andredxc/Microcontroladores/esquematico/final.pdf

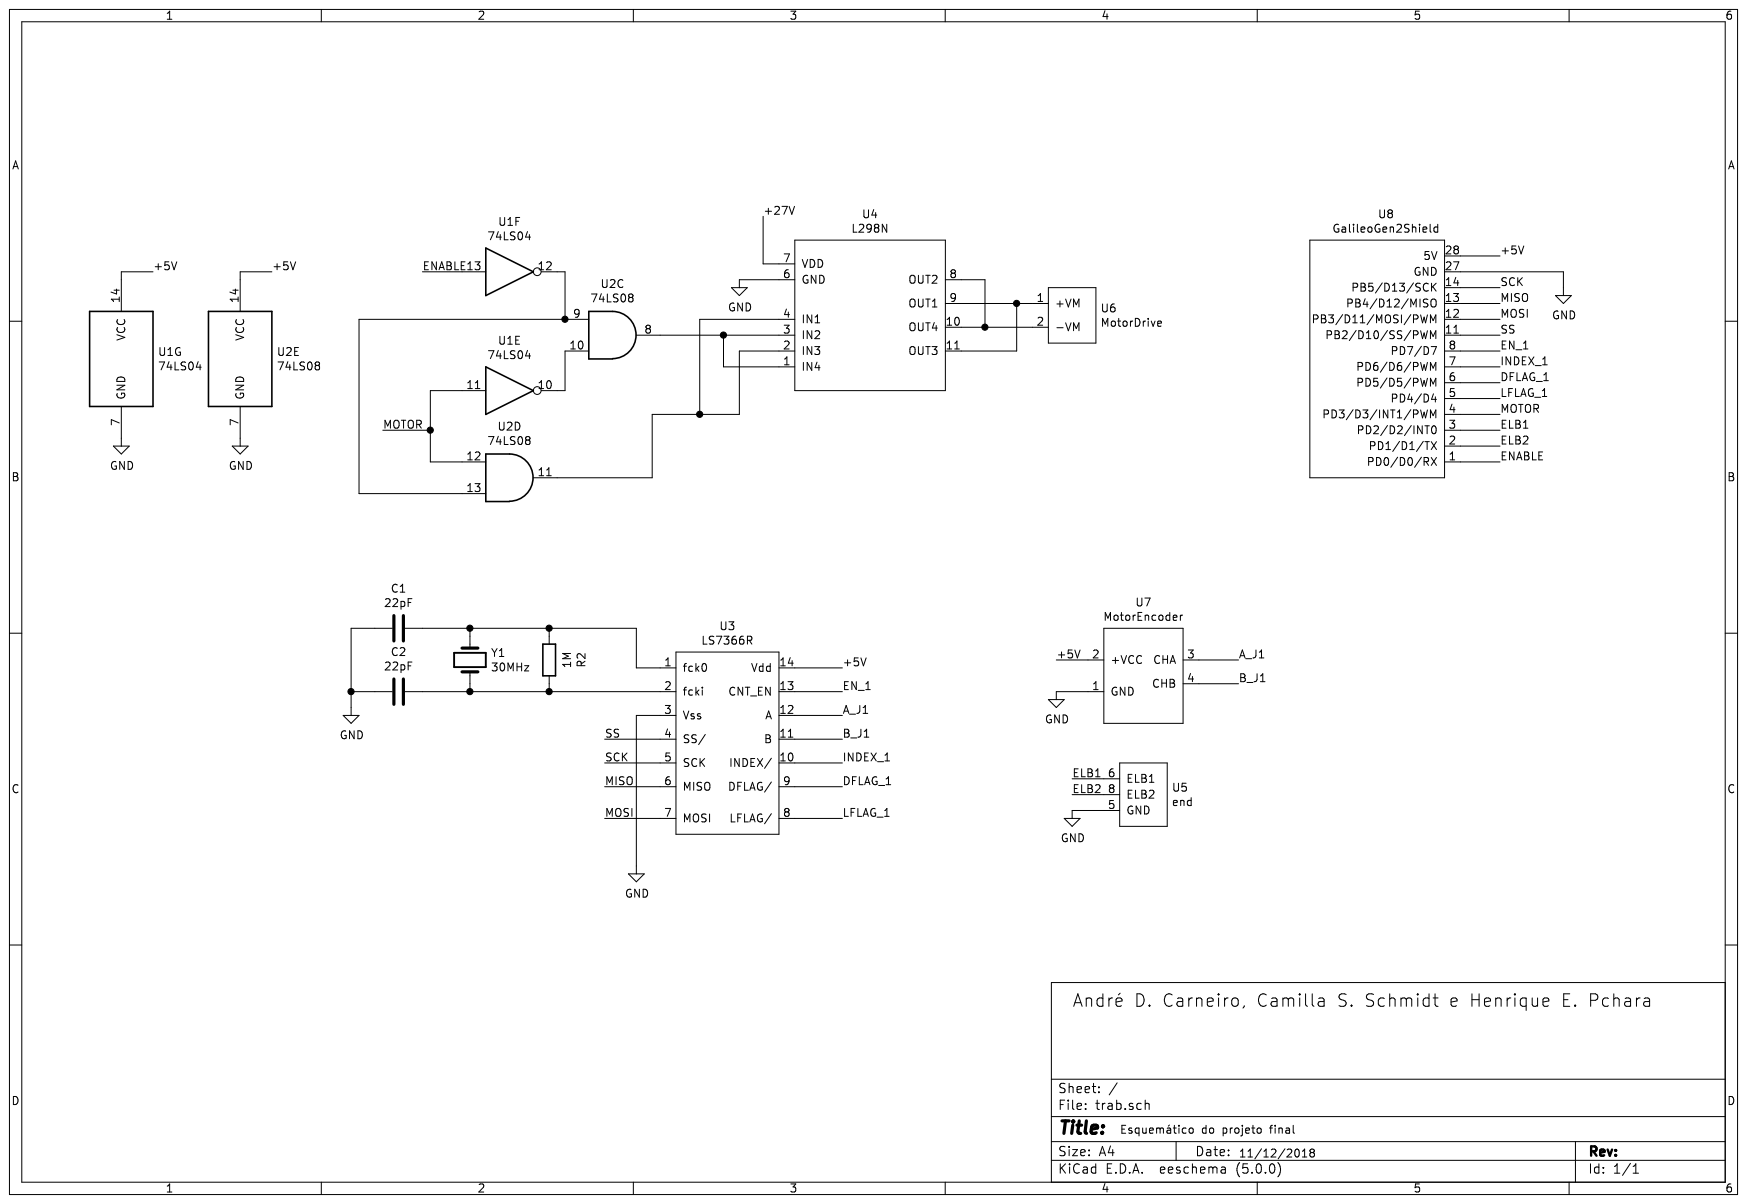
[picture p5: page 1]
