andredxc/Microcontroladores/PCB/versao3.pdf

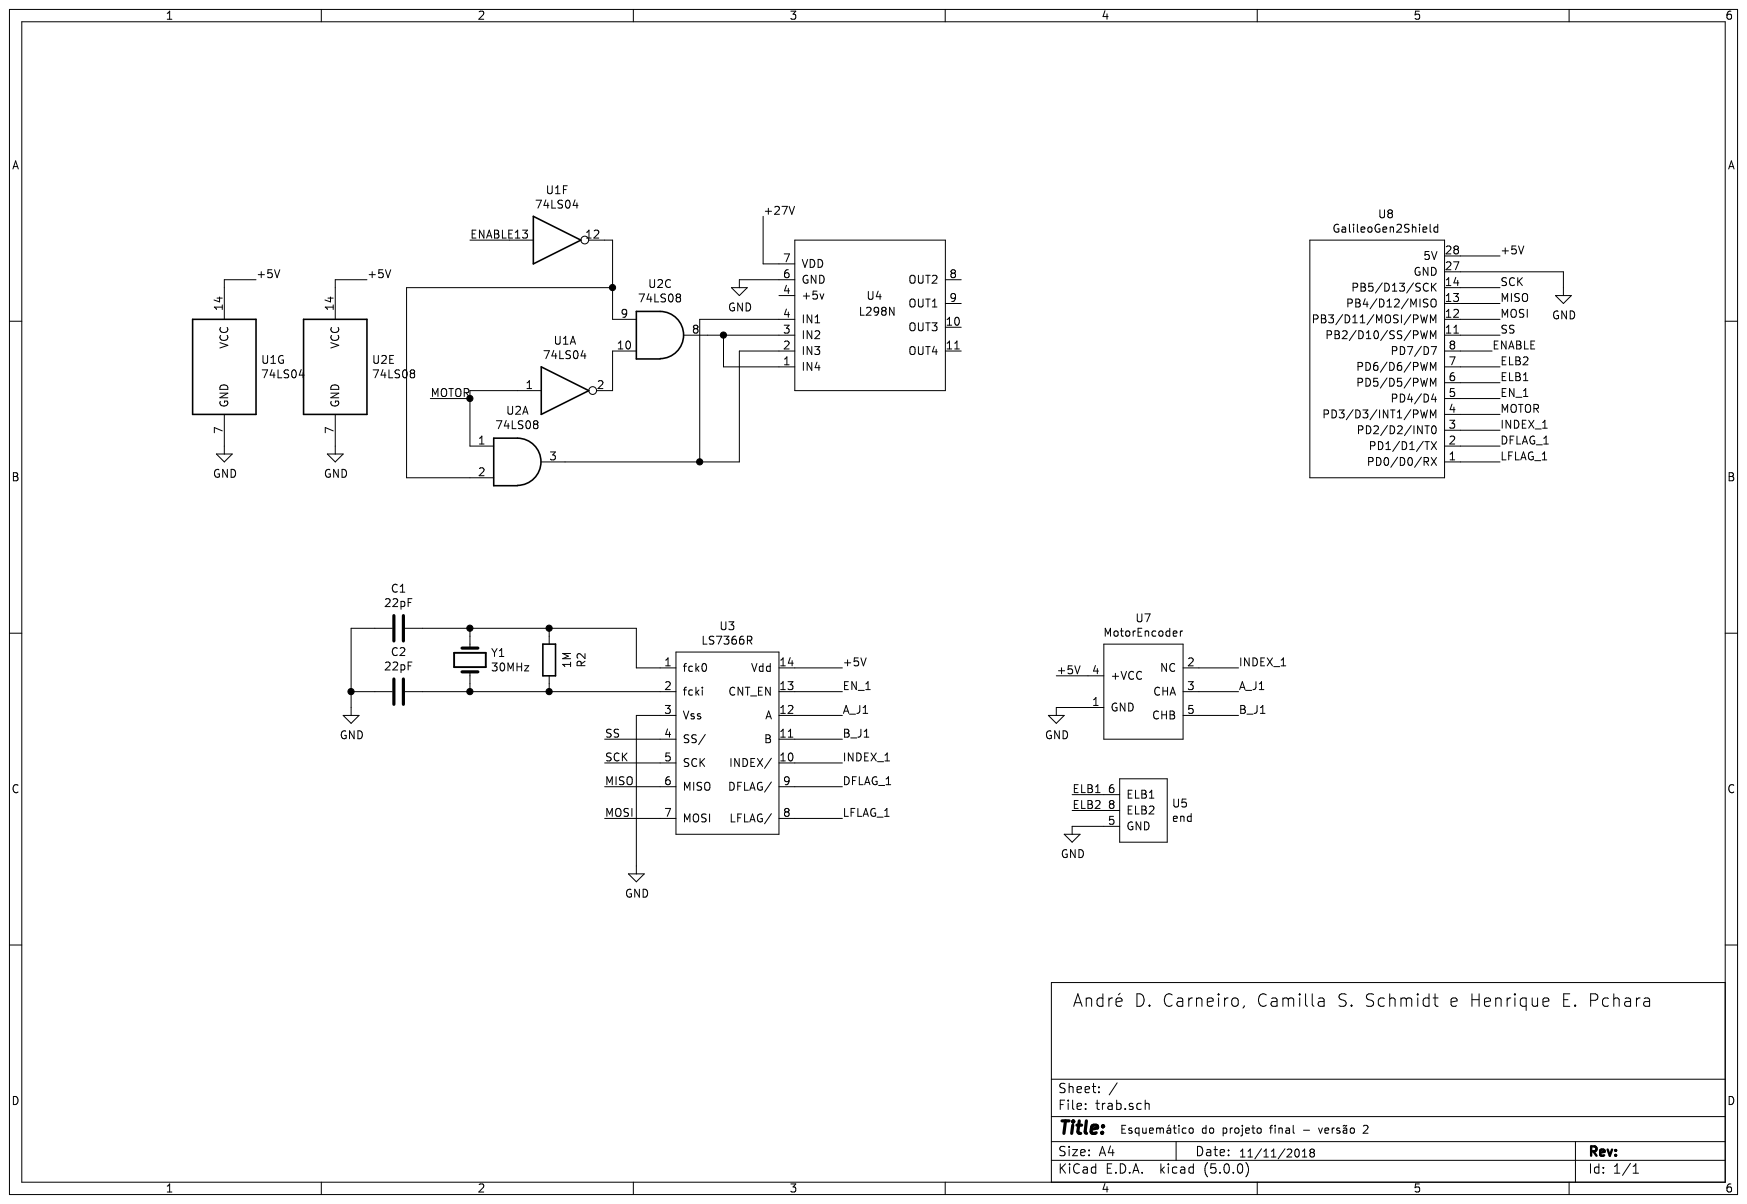
[picture p6: page 1]
