andredxc/Microcontroladores/PCB/versao2.pdf

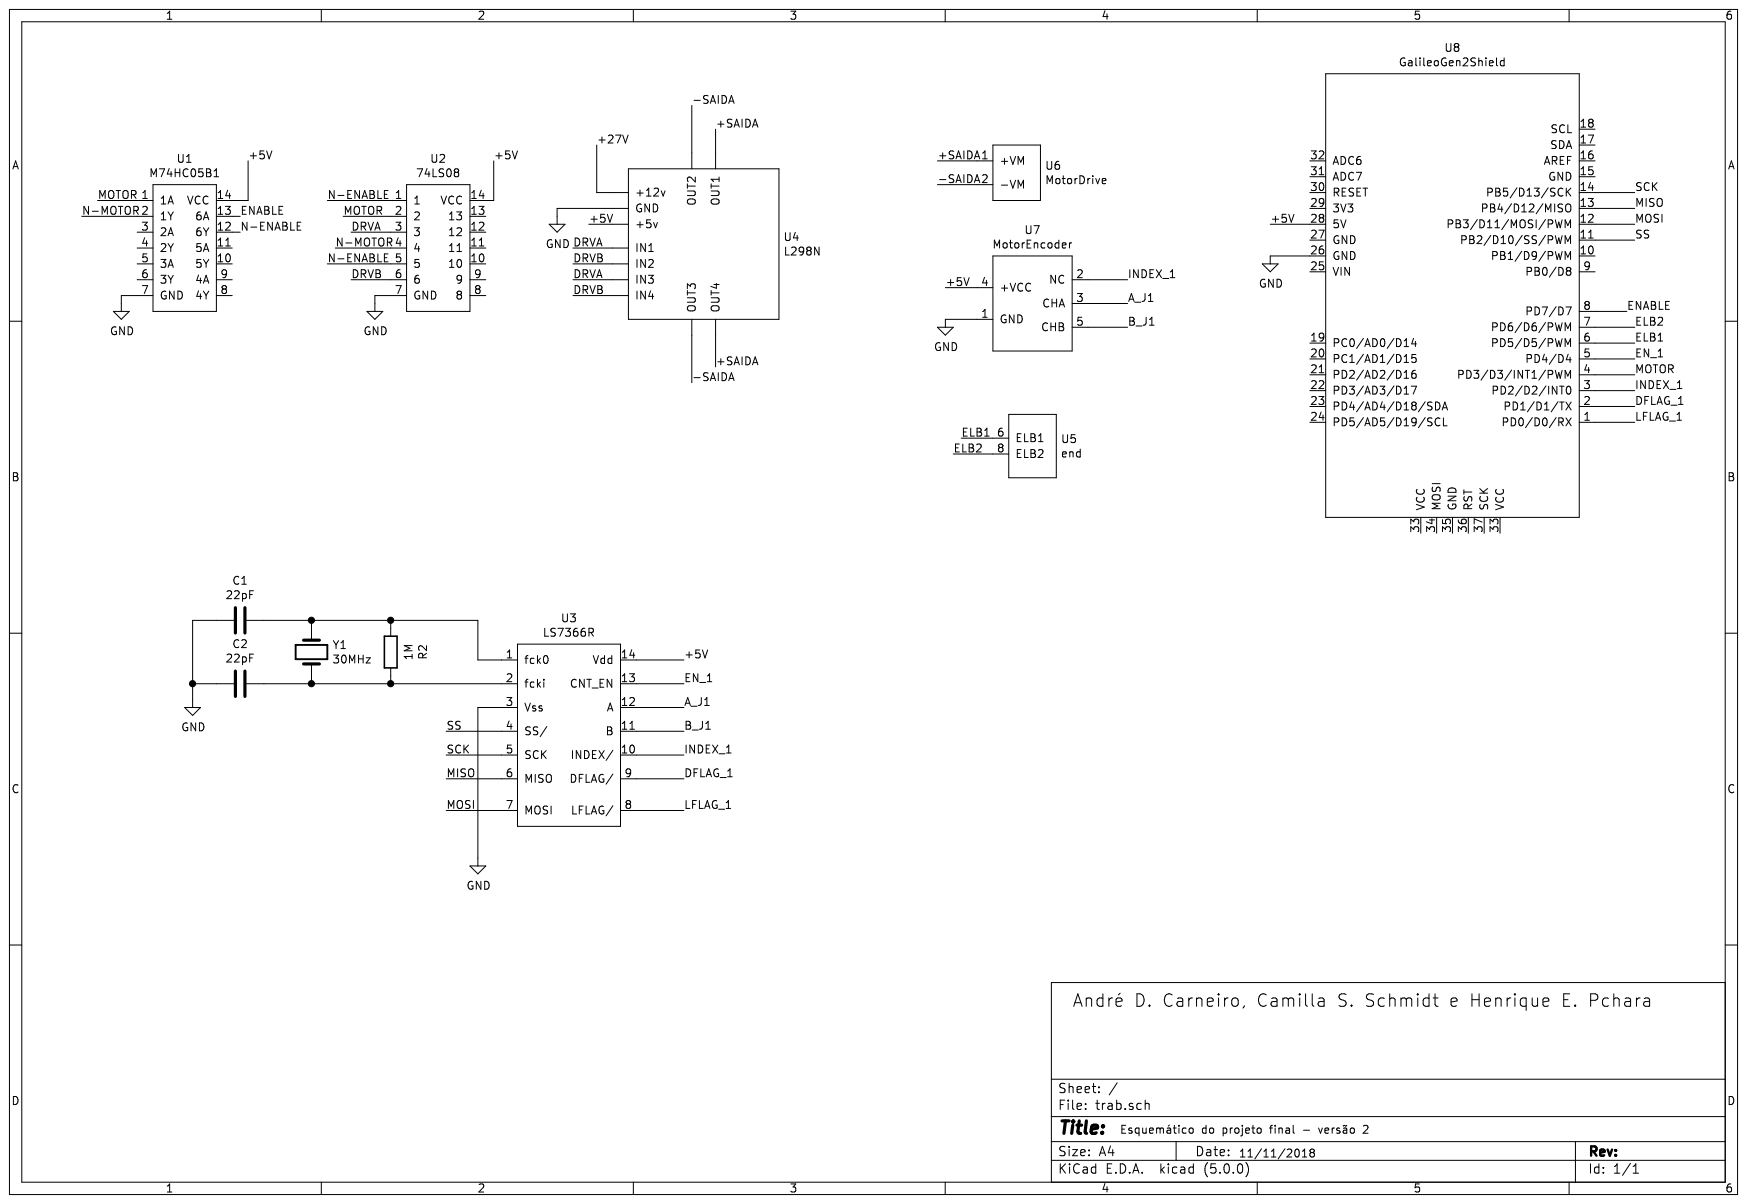
[picture p7: page 1]
