andredxc/Microcontroladores/Entrega/Esquemáticos/layout_all_layers.pdf

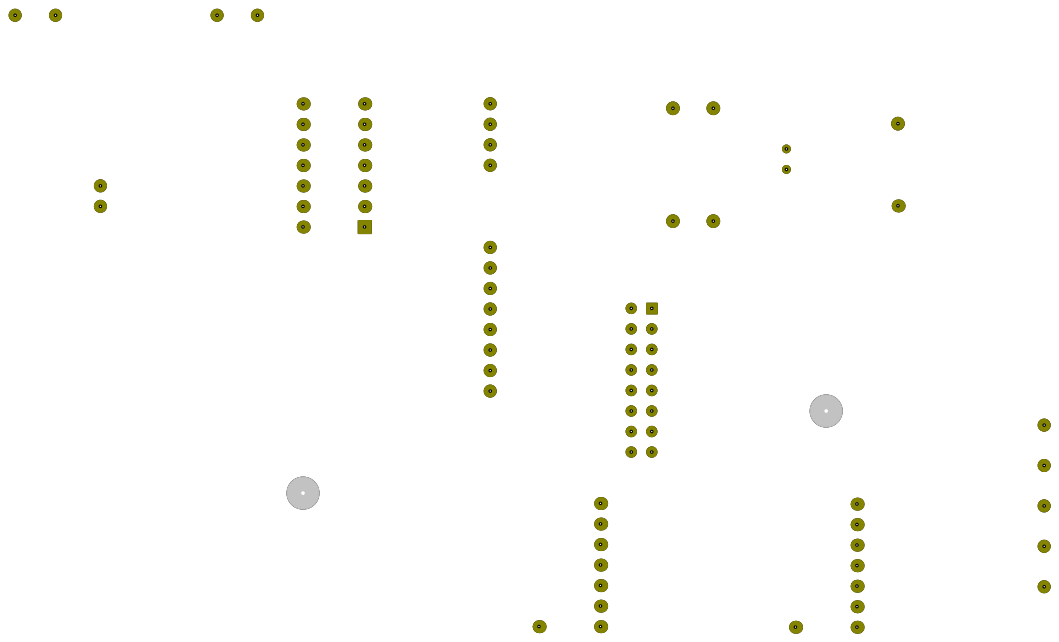
[picture p8: page 1]

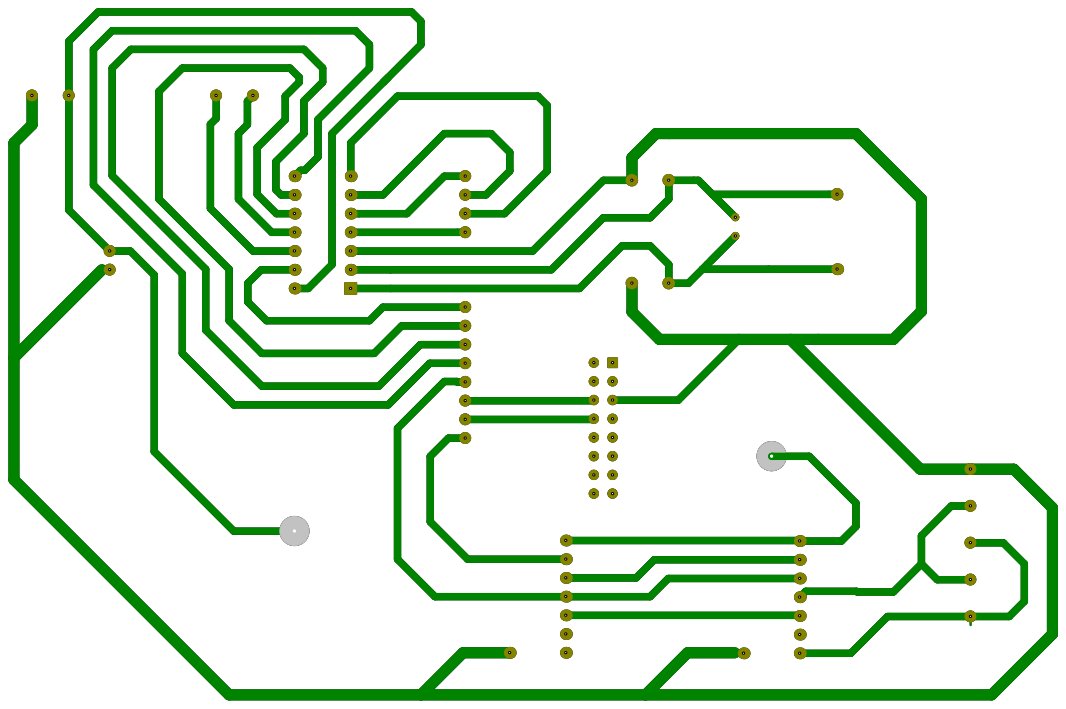
[picture p9: page 2]

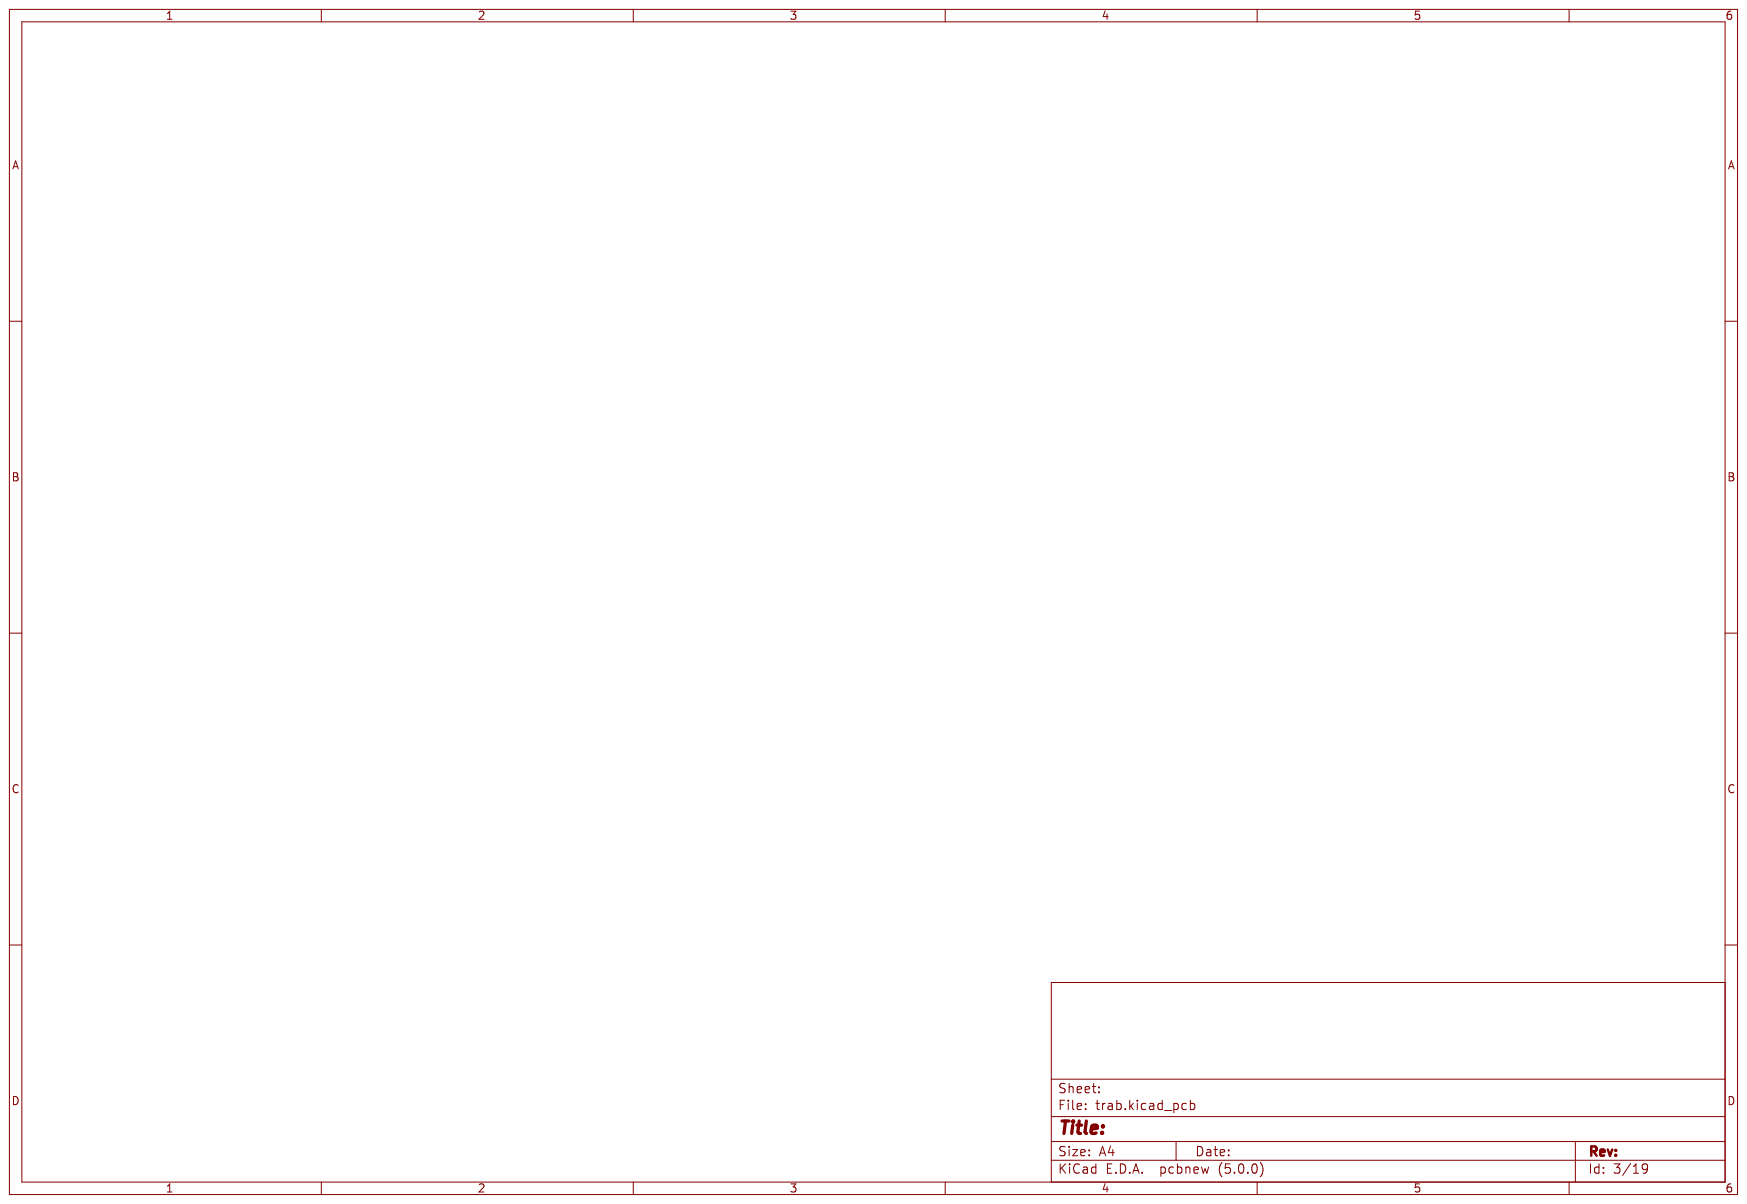
[picture p10: page 3]

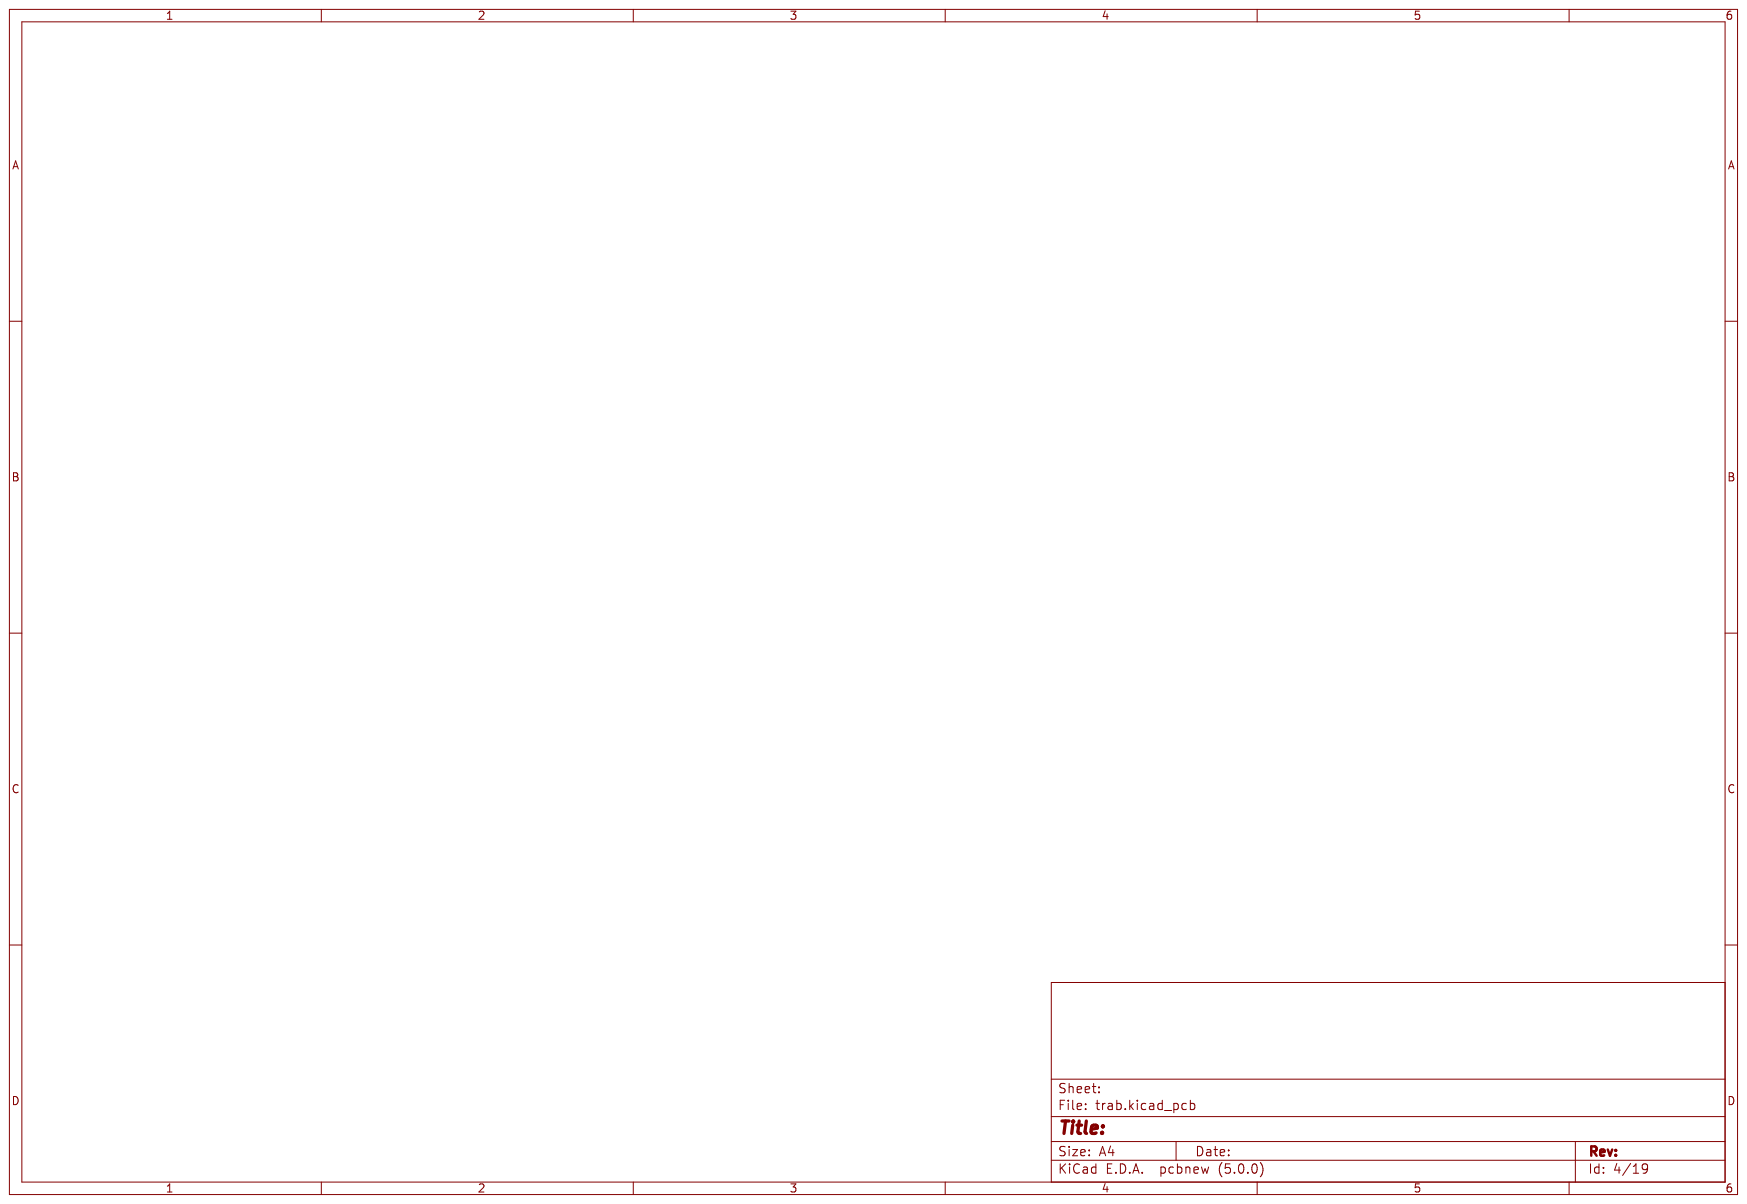
[picture p11: page 4]

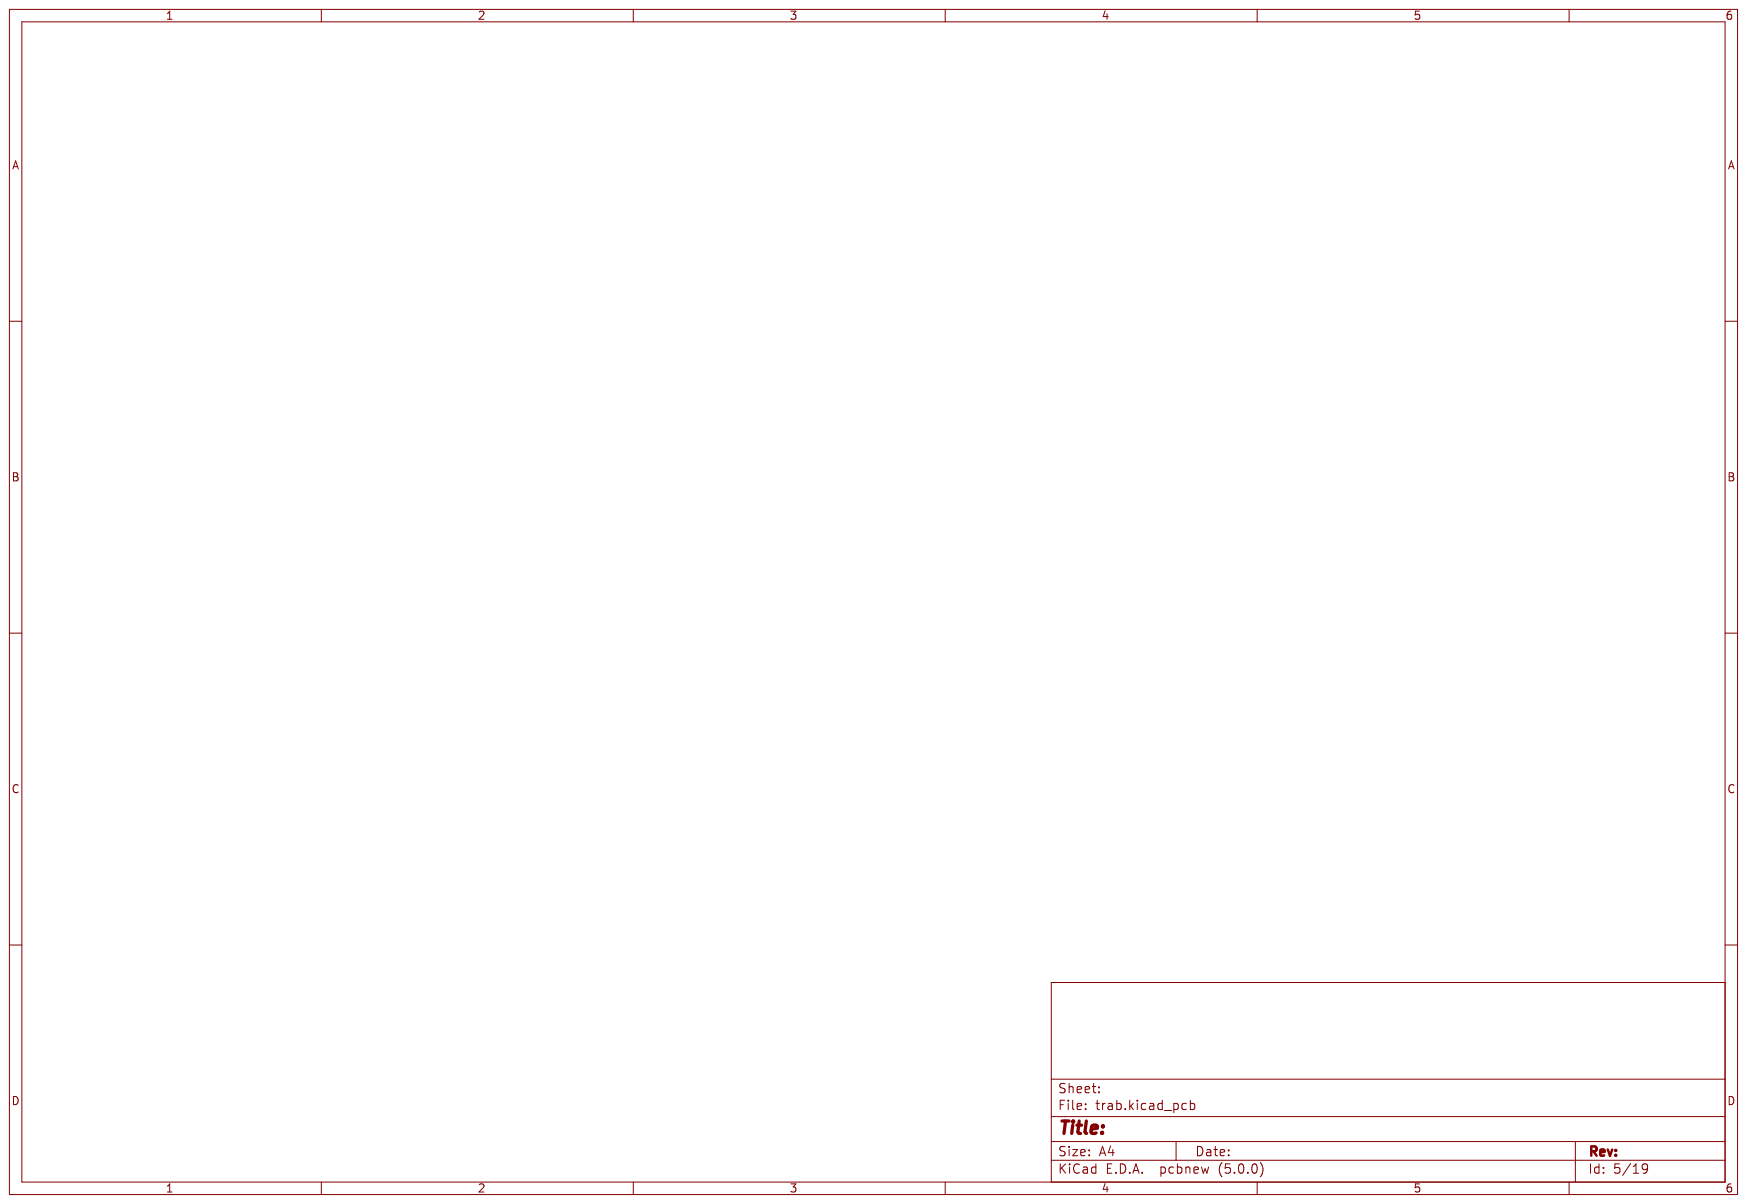
[picture p12: page 5]

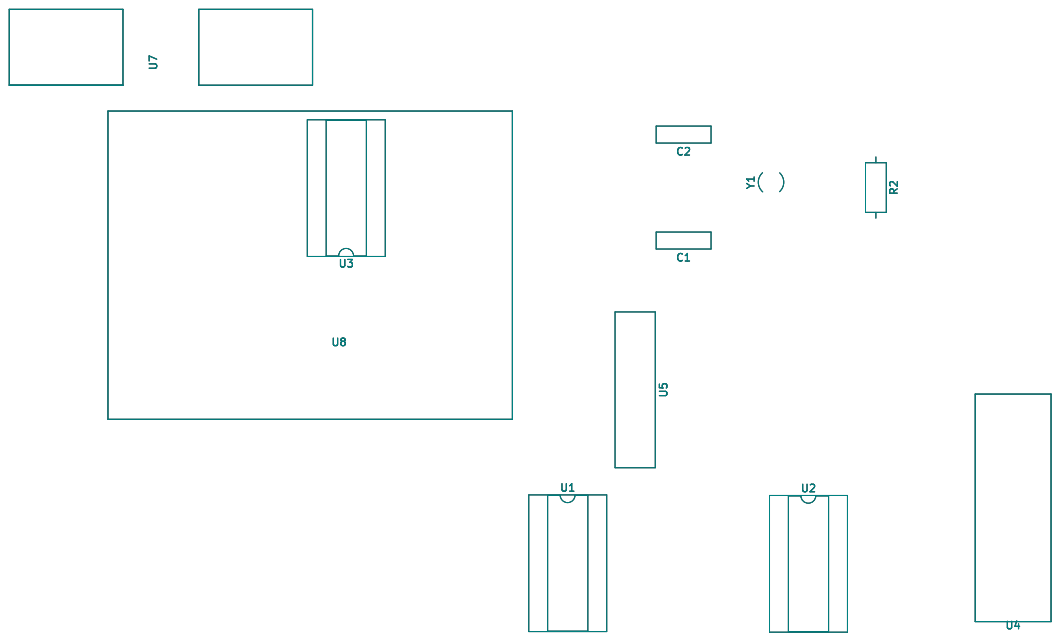
[picture p13: page 6]

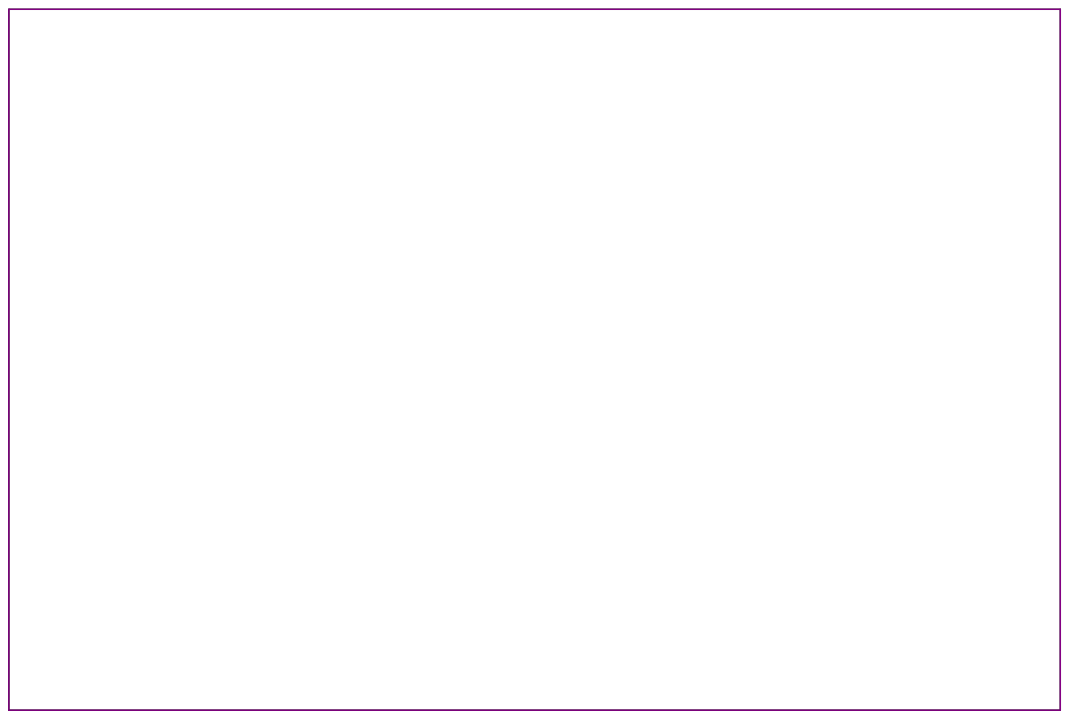
[picture p14: page 7]

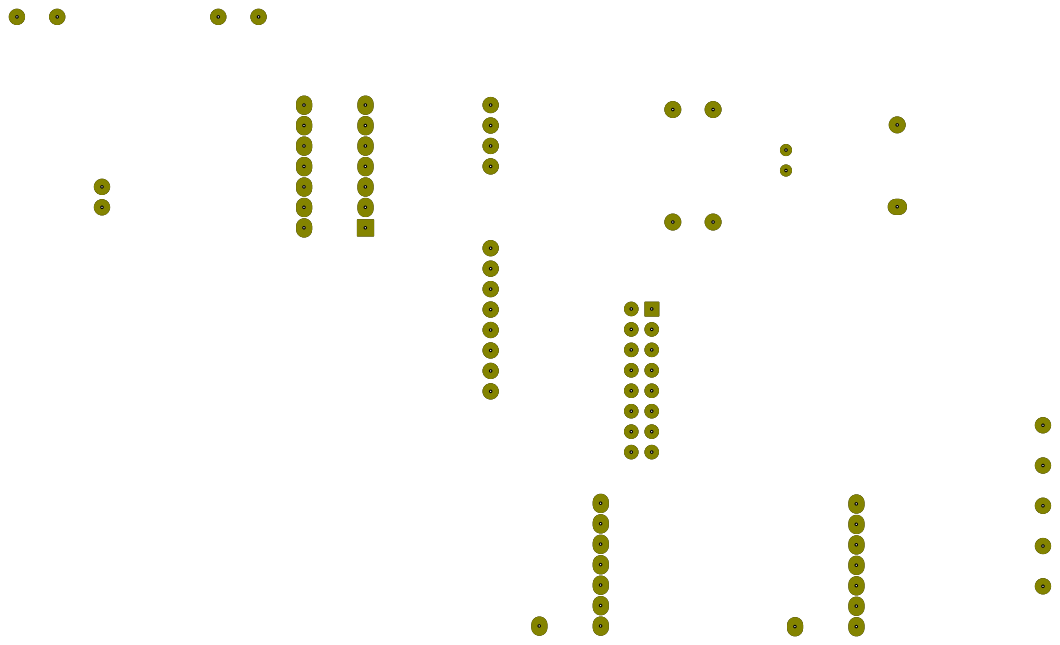
[picture p15: page 8]

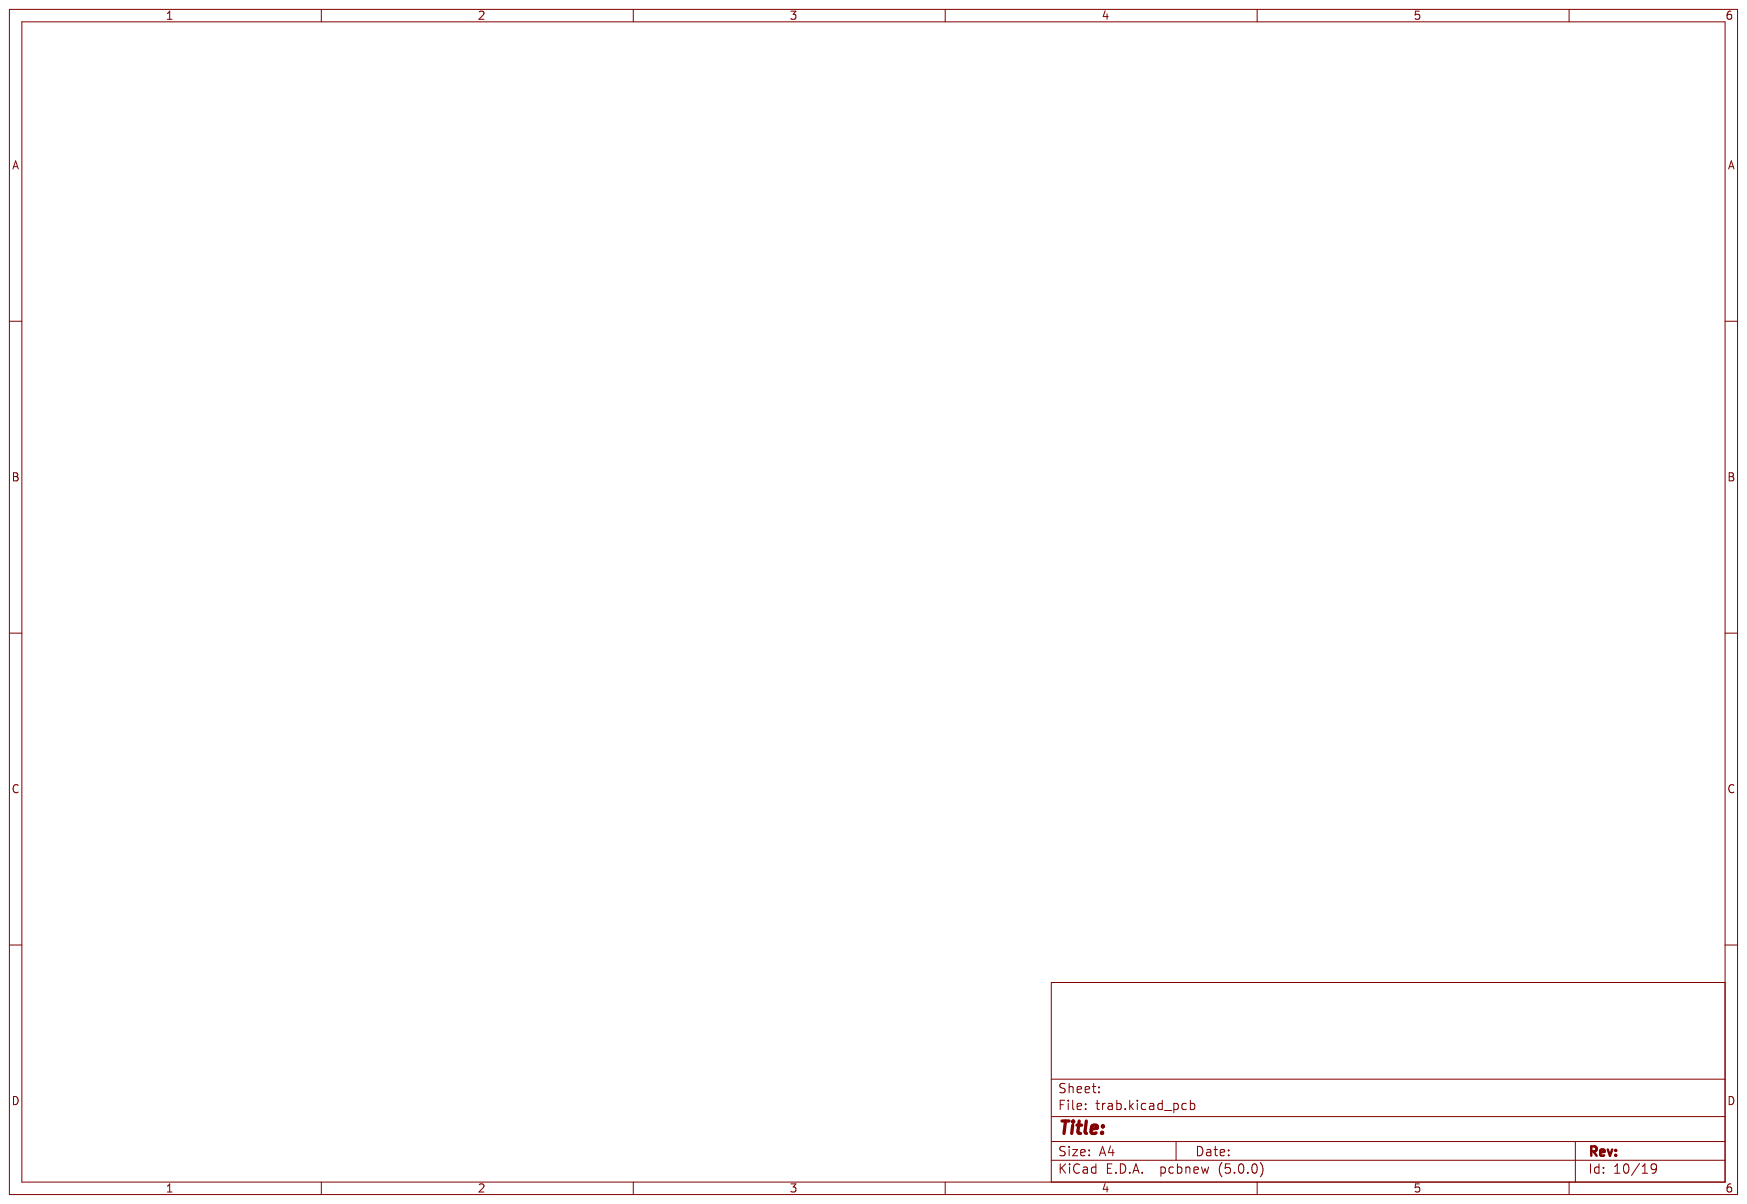
[picture p16: page 10]

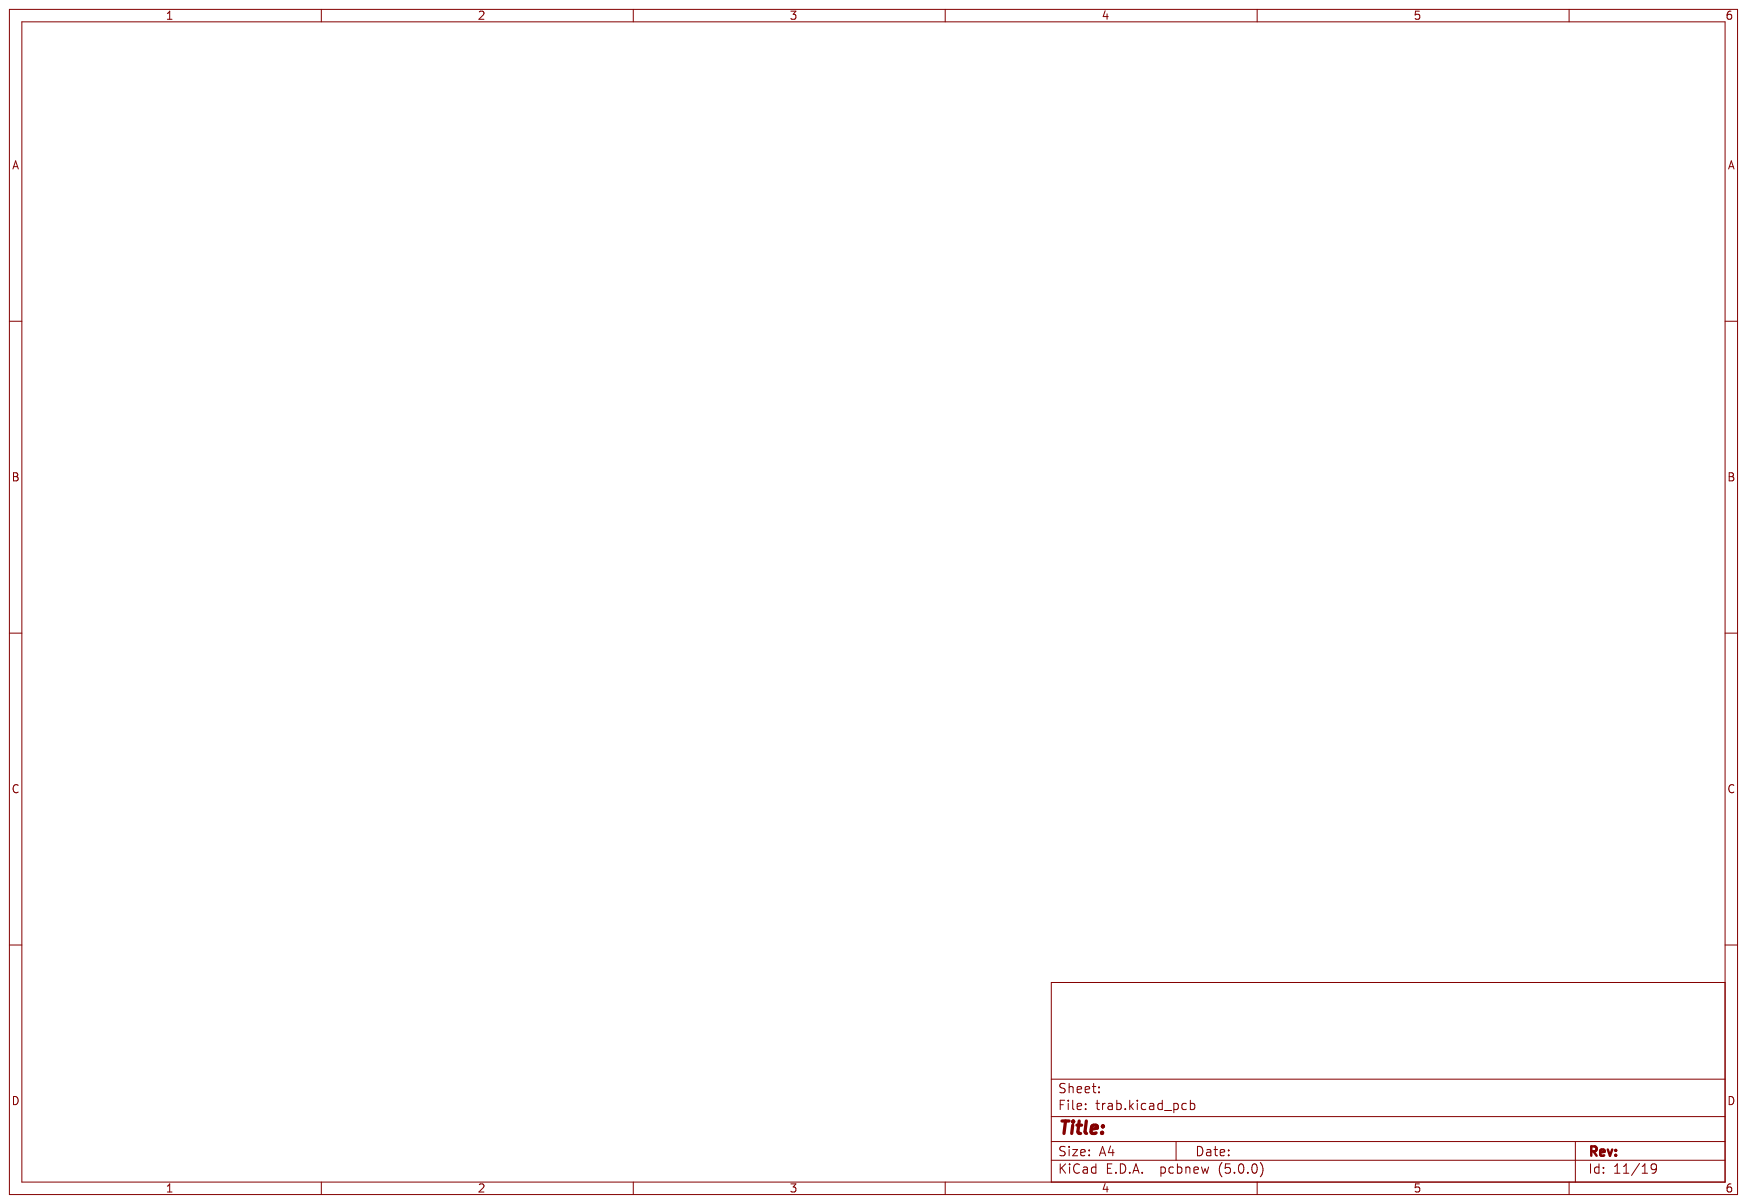
[picture p17: page 11]

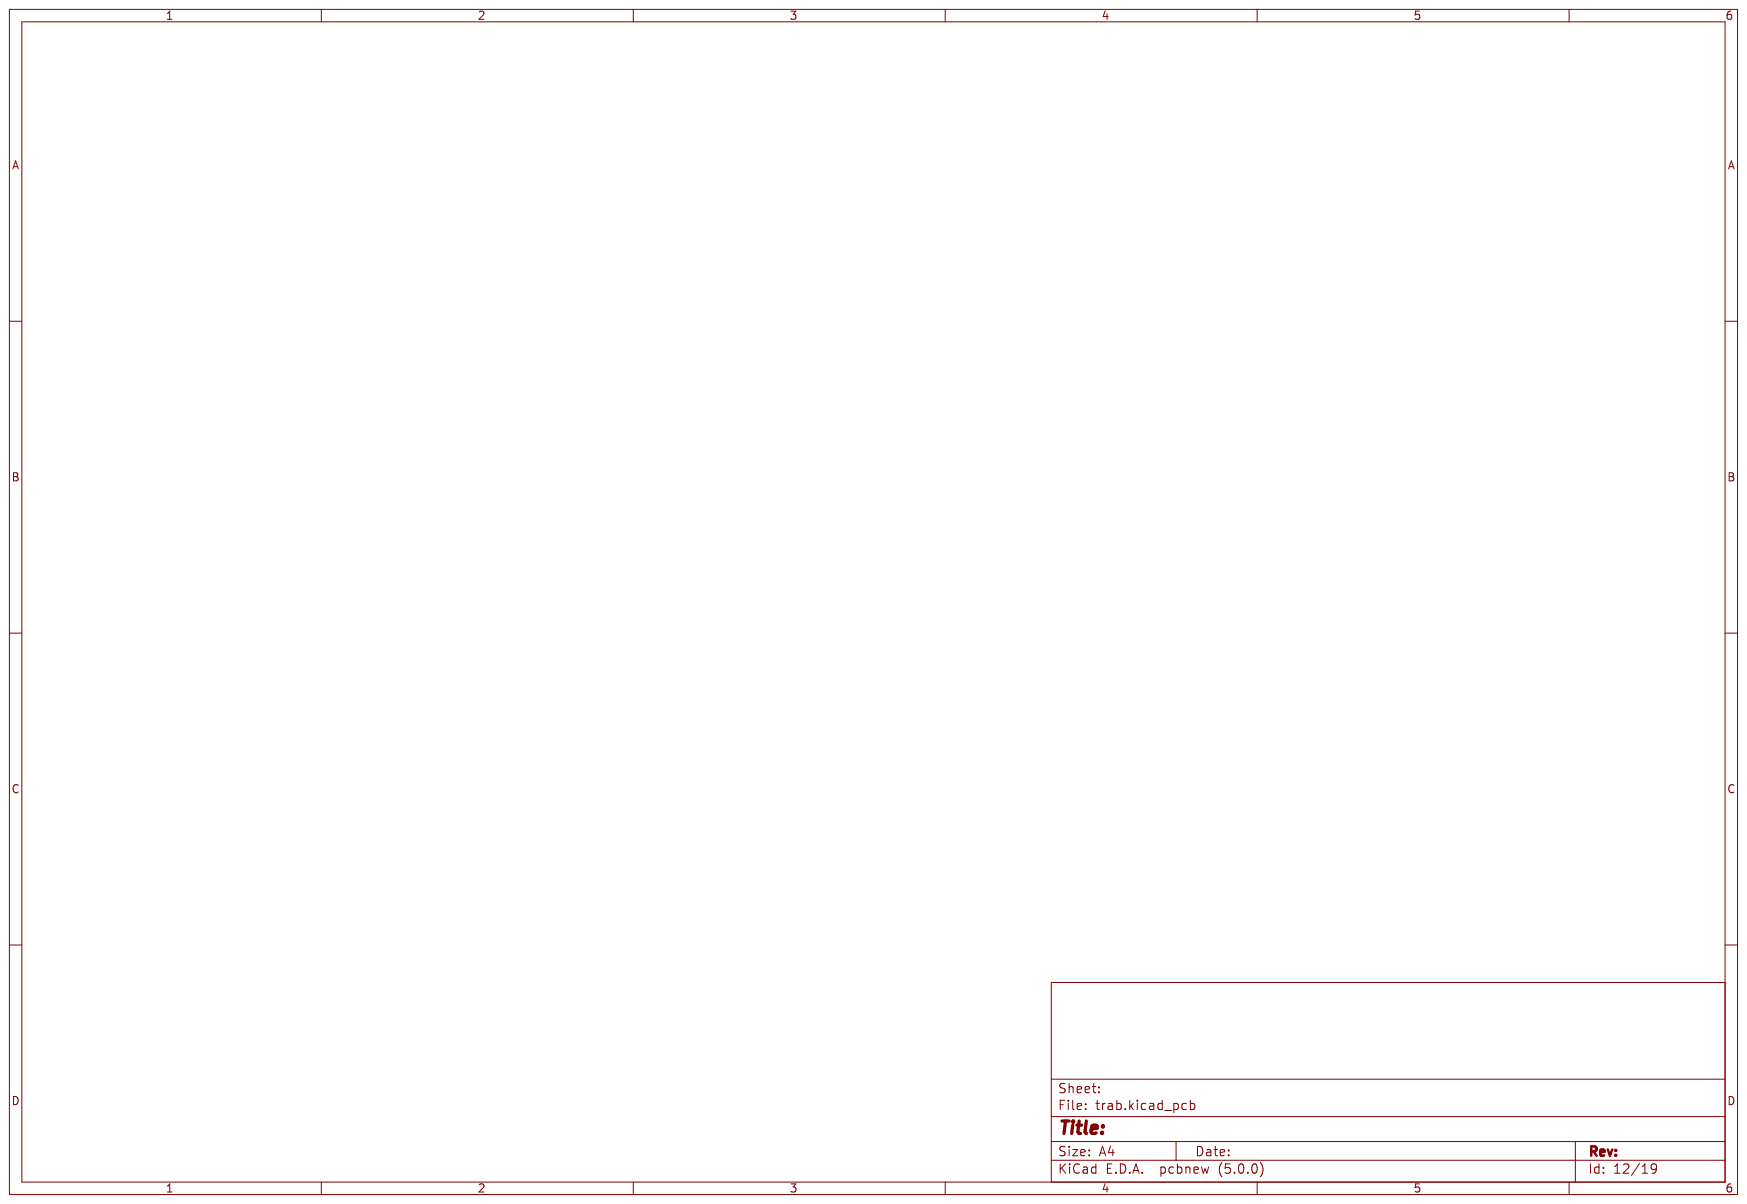
[picture p18: page 12]

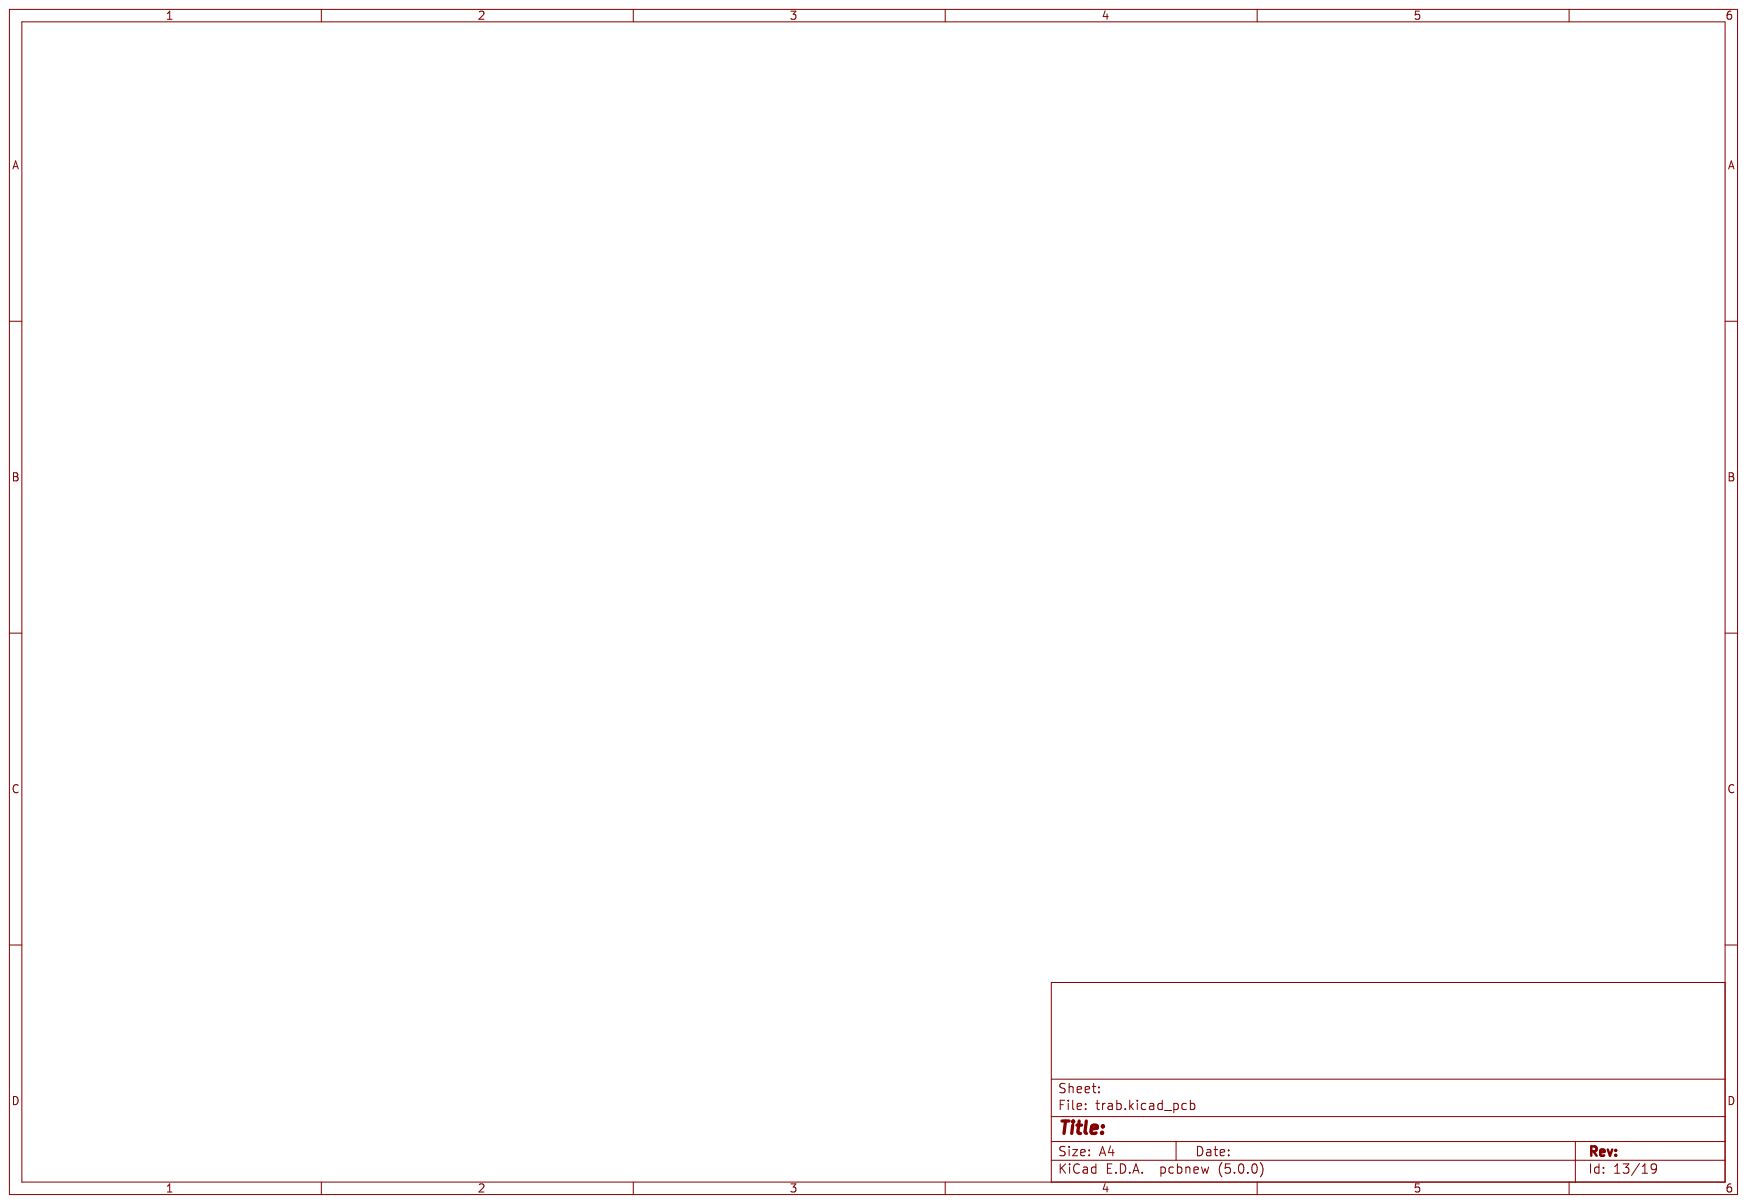
[picture p19: page 13]

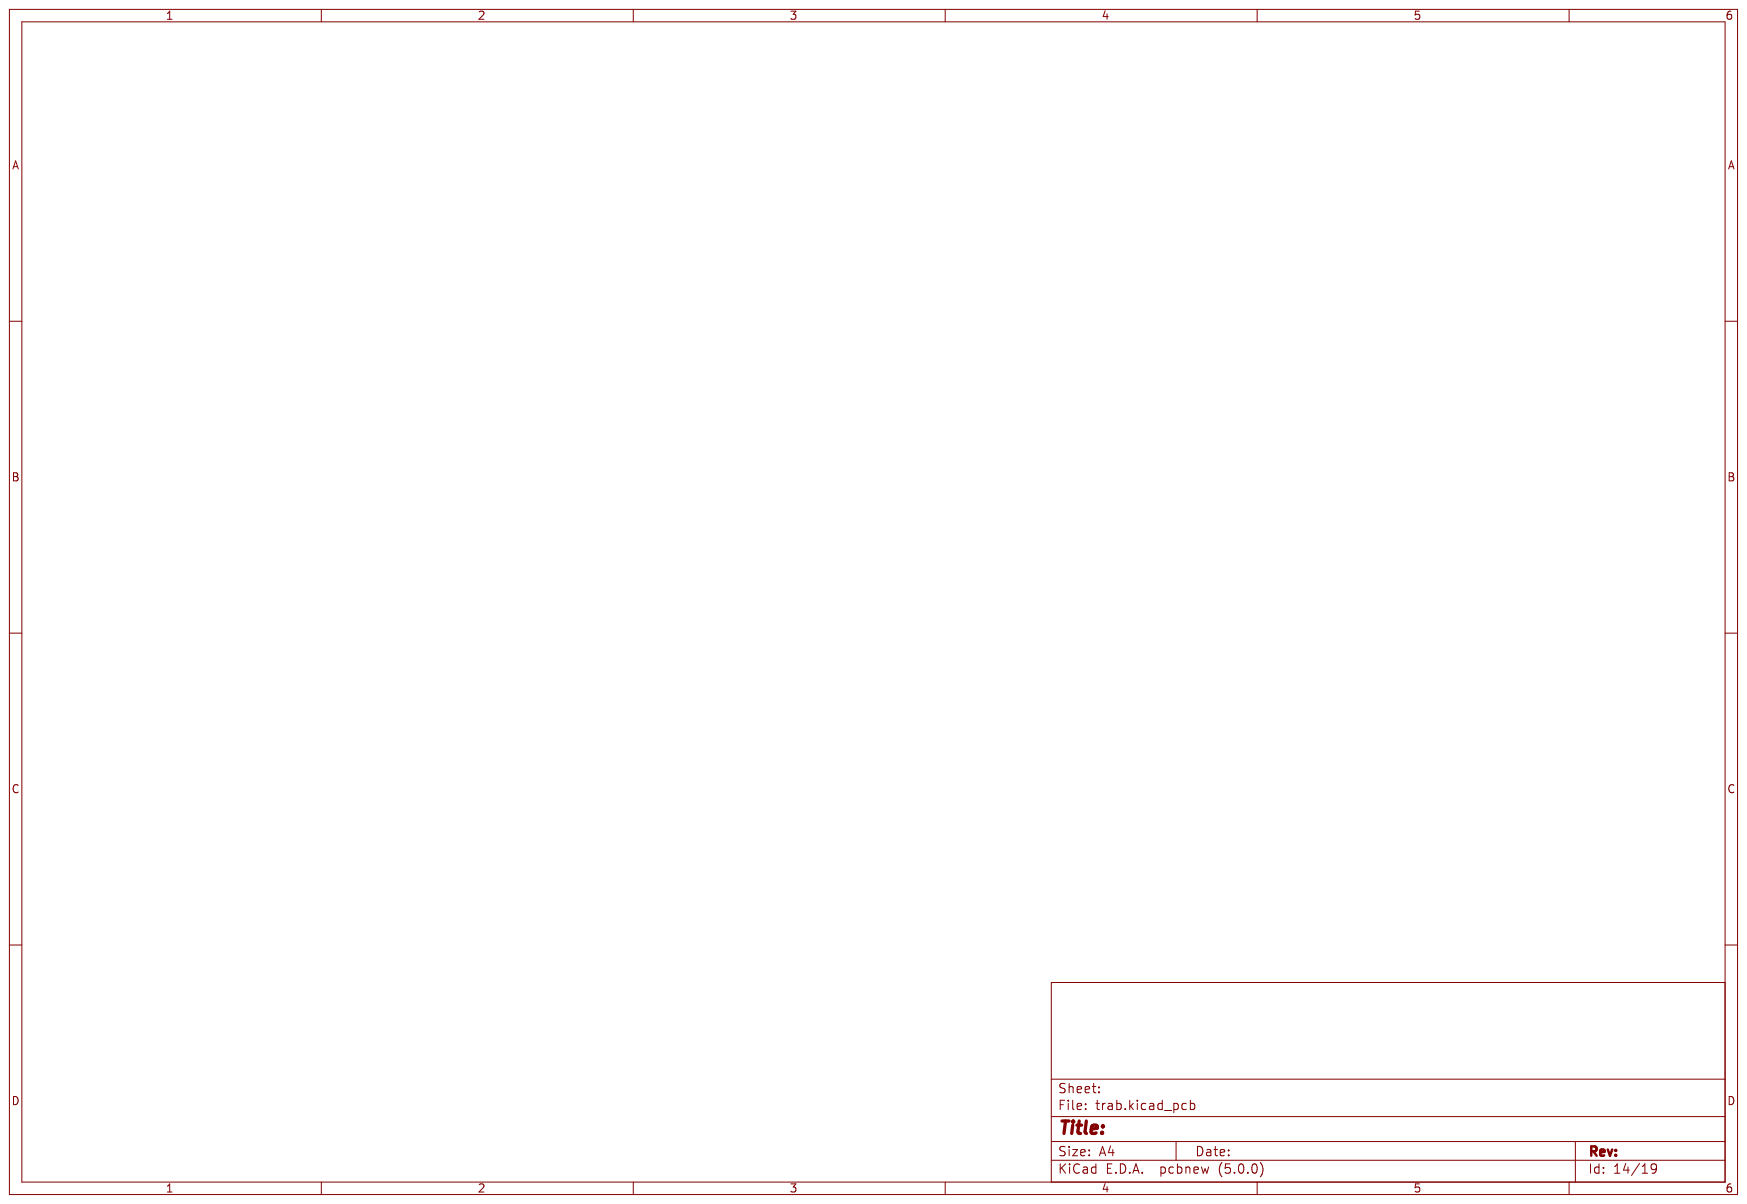
[picture p20: page 14]

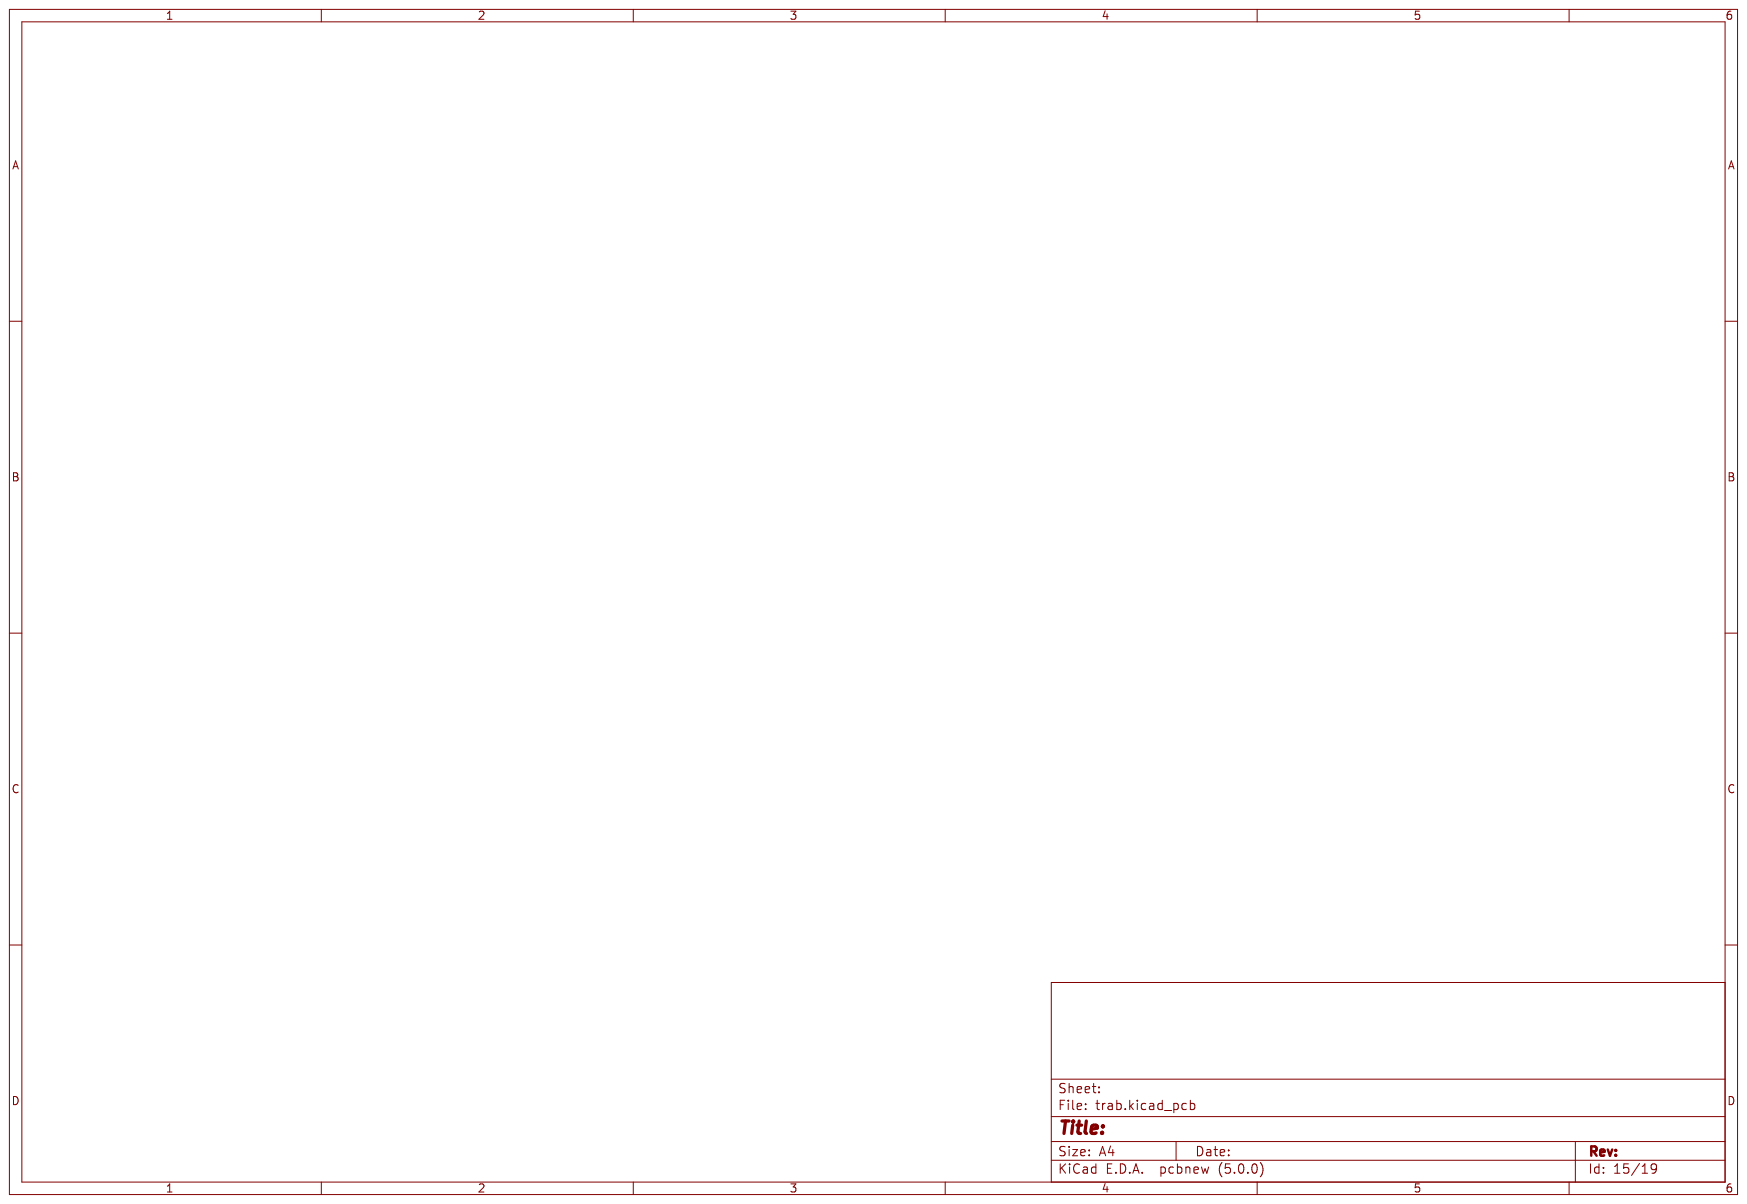
[picture p21: page 15]

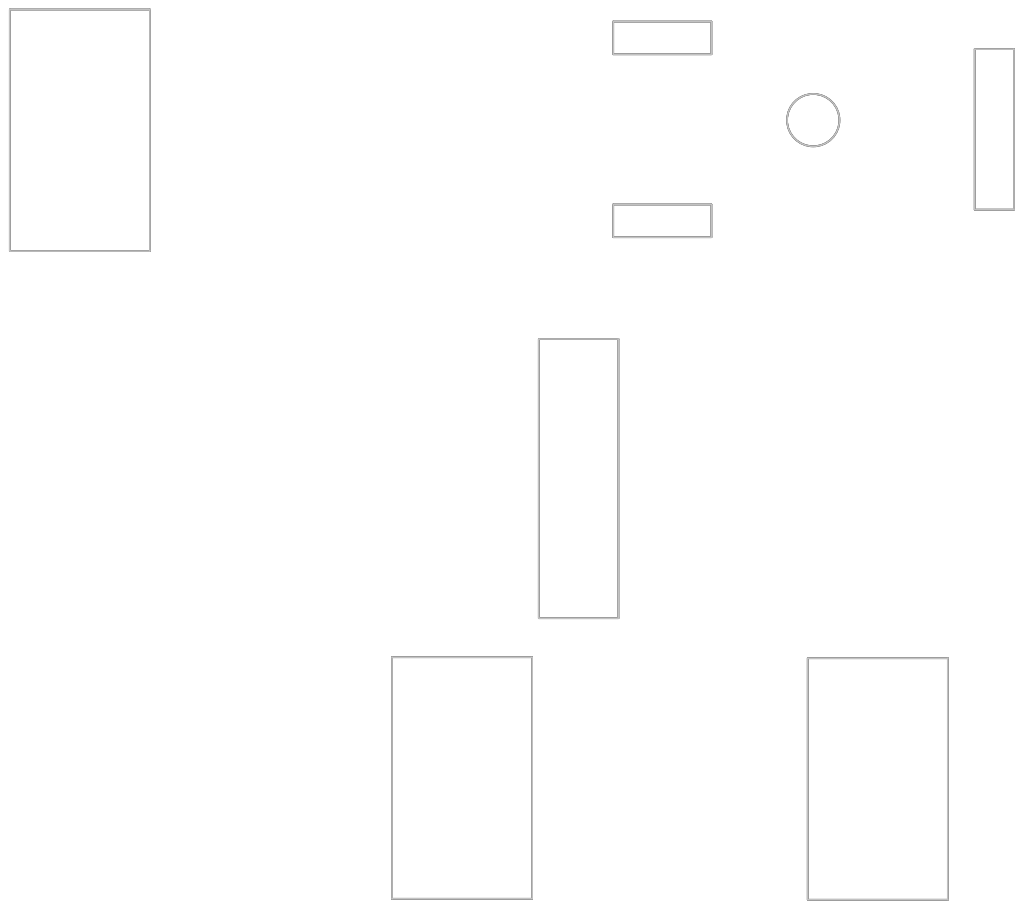
[picture p22: page 16]

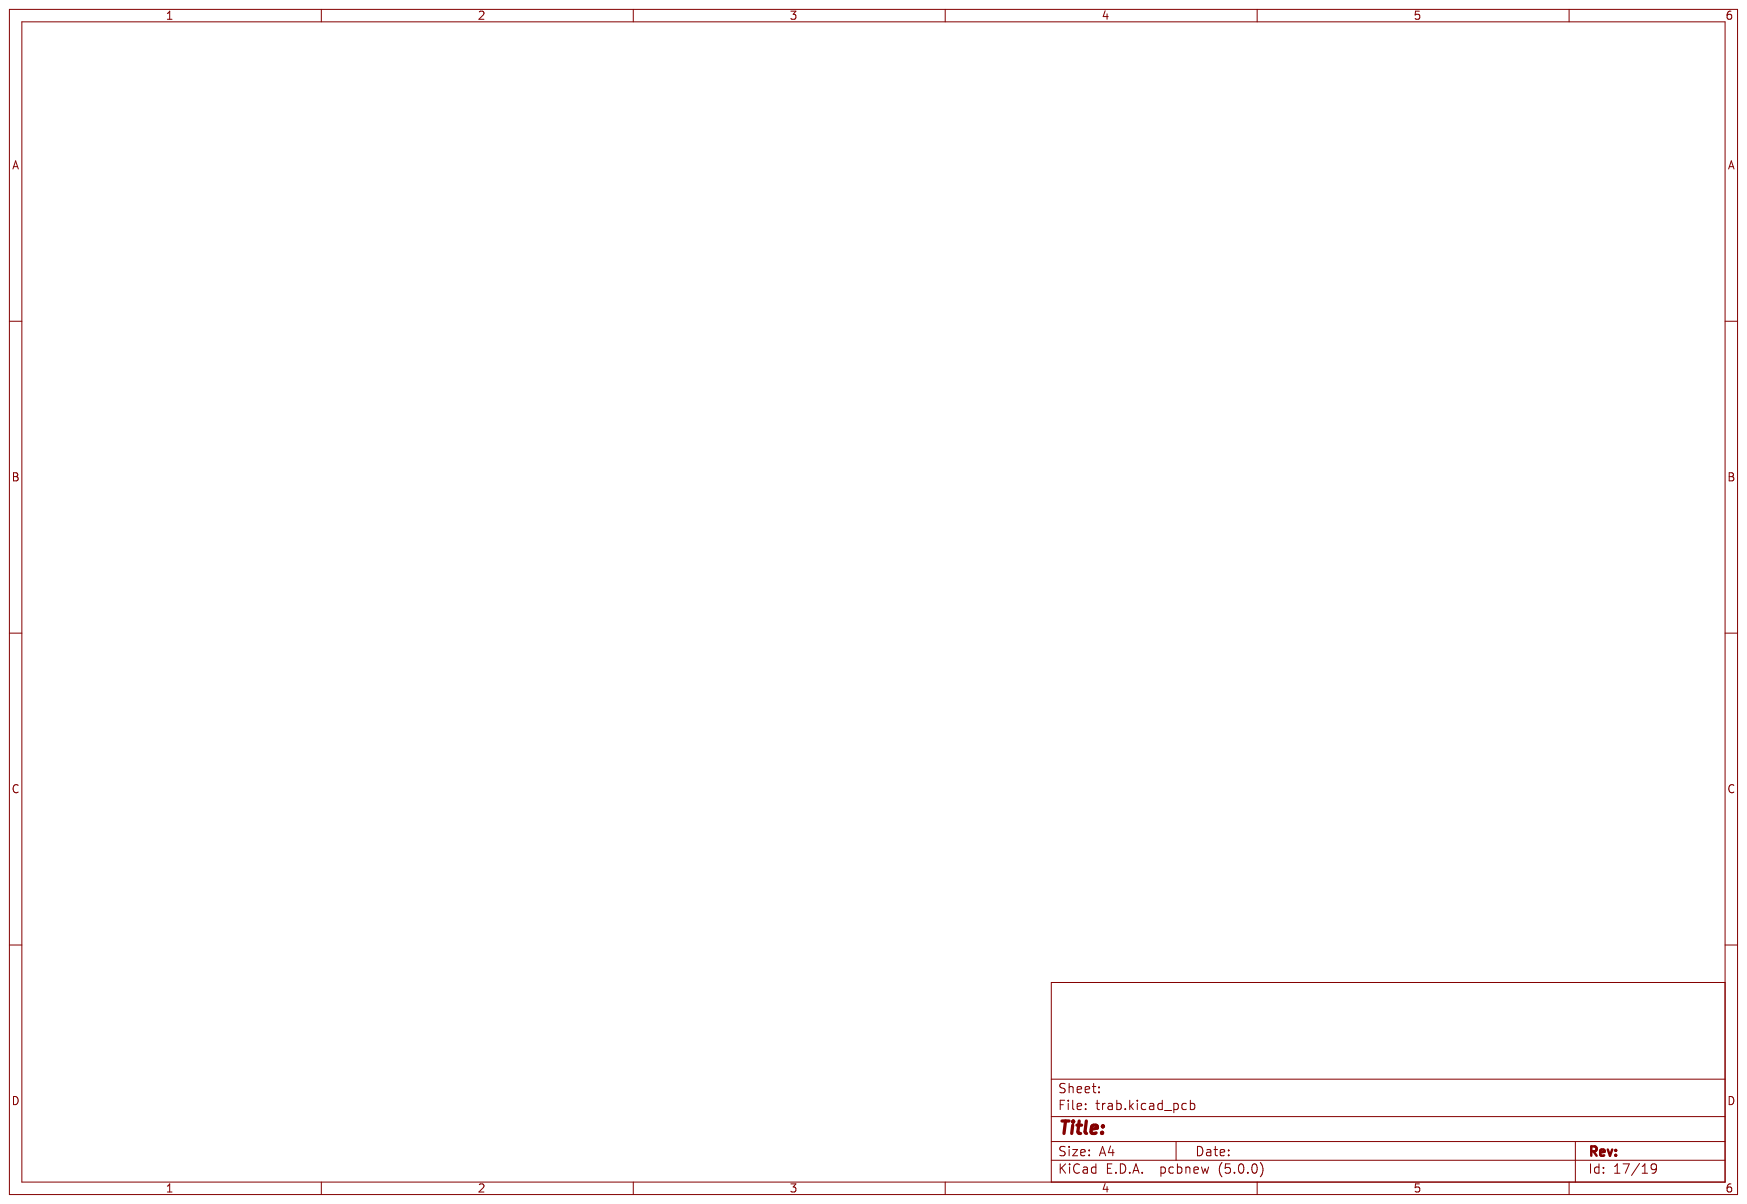
[picture p23: page 17]

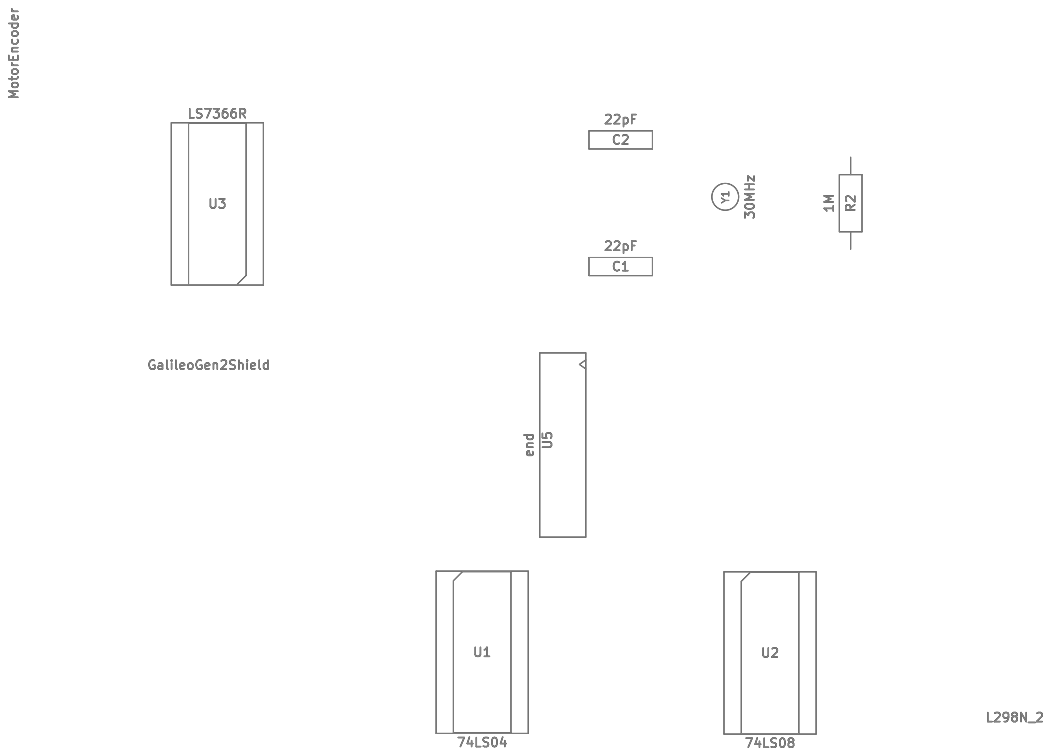
[picture p24: page 18]

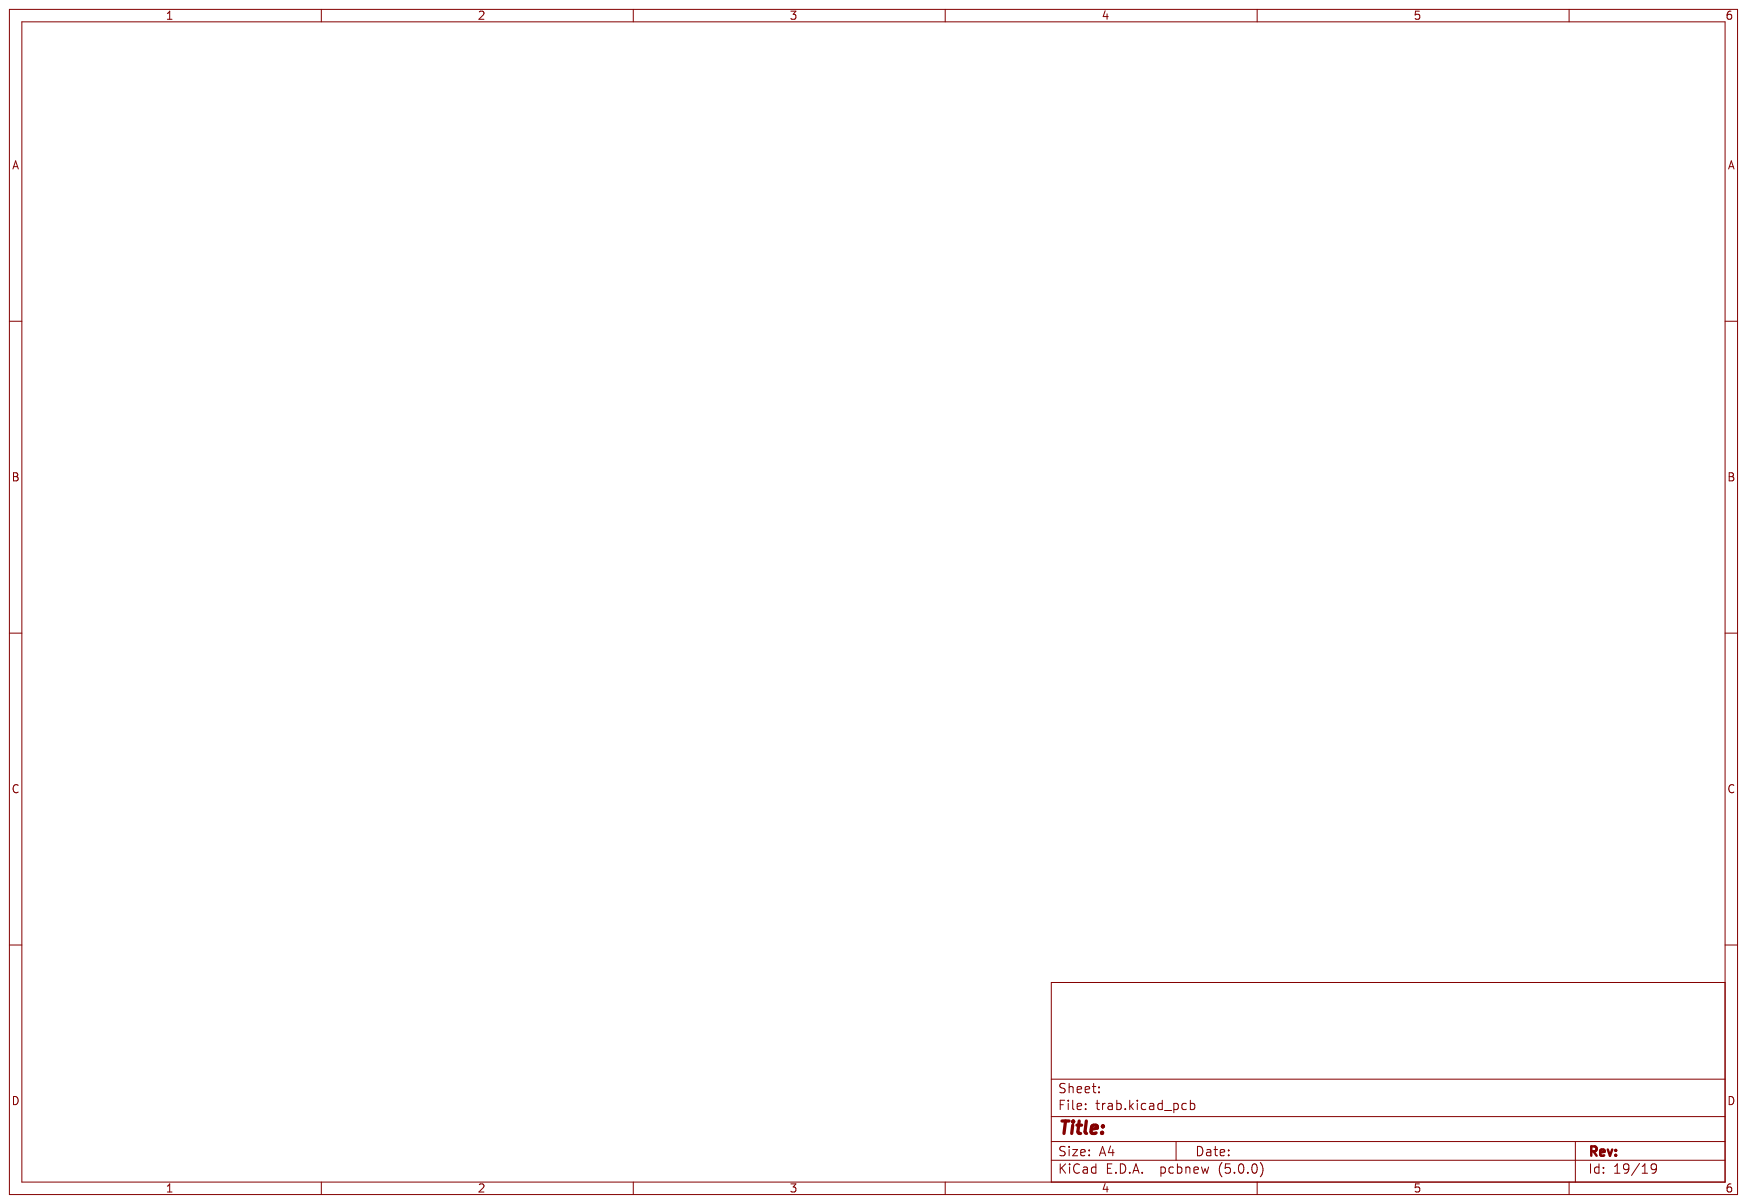
[picture p25: page 19]
