andredxc/Microcontroladores/PCB/trab.kicad_pcb

## KiCad design PCB/trab.kicad_pcb (2018-12-12)

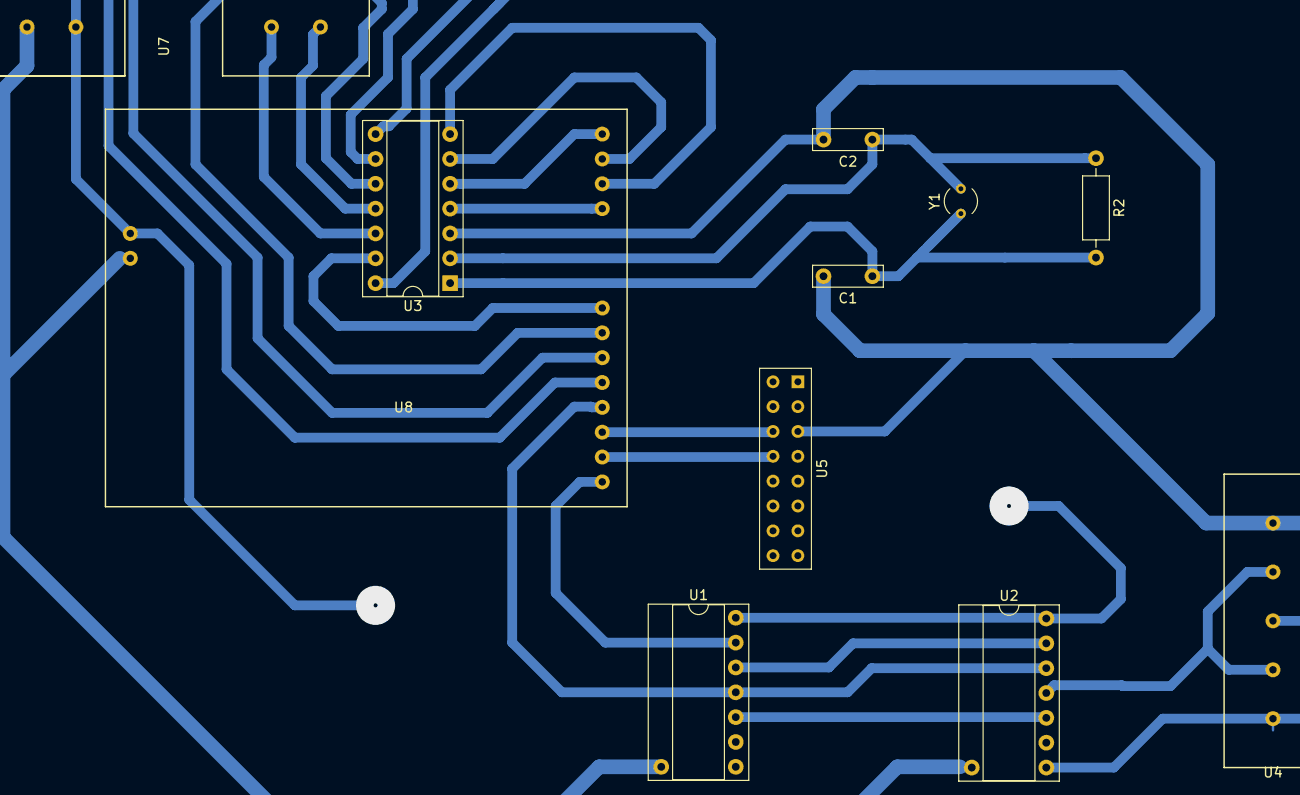
[picture p26: board trab.kicad_pcb from above]

Board: 2 copper layers, 11 parts (0 on the bottom side), 22 nets.

Parts:
C1, C2: 22pF; C_Rect_L7.0mm_W2.0mm_P5.00mm
R2: 1M; R_Axial_DIN0207_L6.3mm_D2.5mm_P10.16mm_Horizontal
U1: 74LS04; DIP-14_W7.62mm_Socket
U2: 74LS08; DIP-14_W7.62mm_Socket
U3: LS7366R; DIP-14_W7.62mm_Socket
U4: L298N_2; krex5
U5: end; Samtec_HLE-116-02-xx-DV-TE_2x08_P2.54mm_Horizontal
U7: MotorEncoder; krex4
U8: GalileoGen2Shield; galileo
Y1: 30MHz; Crystal_AT310_D3.0mm_L10.0mm_Vertical

Connections:
/+5V: U1.14, U2.14, U3.14, U7.2, U8.28
/A_J1: U3.12, U7.3
/B_J1: U3.11, U7.4
/DFLAG_1: U3.9, U8.6
/ELB1: U5.6, U8.3
/ELB2: U5.8, U8.2
/ENABLE: U1.13, U8.1
/EN_1: U3.13, U8.8
/INDEX_1: U3.10, U8.7
/LFLAG_1: U3.8, U8.5
/MISO: U3.6, U8.13
/MOSI: U3.7, U8.12
/MOTOR: U1.11, U2.12, U8.4
/SCK: U3.5, U8.14
/SS: U3.4, U8.11
GND: C1.2, C2.2, U1.7, U2.7, U3.3, U4.6, U5.5, U7.1, U8.27
unnamed: C1.1, R2.2, U3.1, Y1.1
unnamed: C2.1, R2.1, U3.2, Y1.2
unnamed: U1.10, U2.10
unnamed: U1.12, U2.9, U2.13
unnamed: U2.8, U4.1, U4.3
unnamed: U2.11, U4.2, U4.4
