andredxc/Microcontroladores/(commit log)

2018-10-06 Começando
    [trab.kicad_pcb, trab.sch]
2018-10-07 Continuando esquemático
    [trab.sch]
2018-10-07 Arrumando pastas
    [trab.kicad_pcb, trab.sch]
2018-10-11 Terminando esquemático
    [trab.sch]
2018-10-11 Versão entregue
    [trab.sch]
2018-11-27 Começando script
    [trab.kicad_pcb, trab.sch]
2018-12-01 Terminando e testando script de inicialização
2018-12-11 PCB versao 2
    [_saved_trab.sch, trab.kicad_pcb, trab.sch]
2018-12-12 Terminando layout e entrega
    [trab-B.Cu.gbr, trab-B.Mask.gbr, trab-B.Paste.gbr, trab-B.SilkS.gbr, trab-Edge.Cuts.gbr, trab-F.Cu.gbr, trab-F.Mask.gbr, trab-F.Paste.gbr]
2018-12-12 Atualizando fim de curso
